Epicotch/Acoustic-Camera/README.md

hi

Firmware is under firmware, actual board is under Microphone board (KiCAD 10), analysis tools is are in pattern analysis, power viewing utility is under power viewer
