Epicotch/Acoustic-Camera/Microphone board/.step

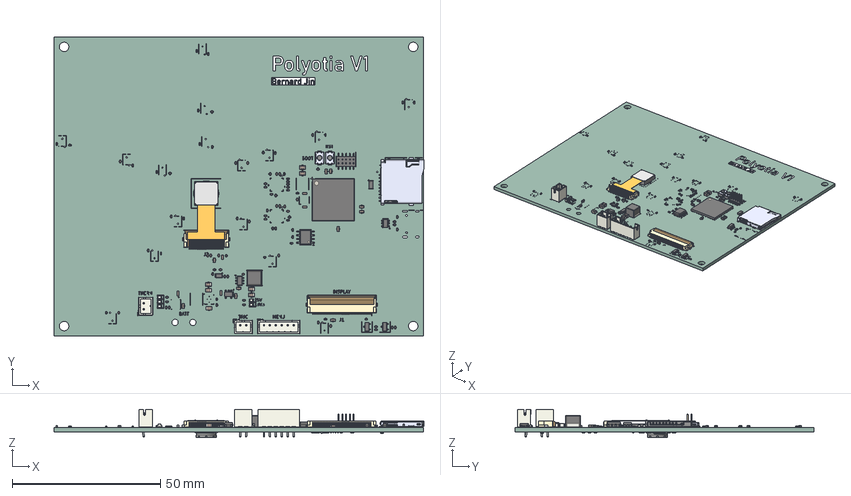
[picture p1: CAD file, 2026-06-13]
Microphone board/.step
124.8 x 101.0 x 9.53 mm
R_0402_1005Metric x 69
lock x 2
pins x 2
C_0603_1608Metric x 15
C_0402_1005Metric x 38
L_Changjiang_FNR5040S
Lense
plate
tail
plate001
conn
film
silk
TS-1088-AR02016 x 2
SOT-23-5
JST_B2B_PH_K x 2
SOIC_8_39x49mm_P127mm
SOT-23 x 2
C_0805_2012Metric x 7
SOT-23-6
LED_0603_1608Metric_Castellated x 5
TSOT-23-6
SOT-583-8
WSON_12_1EP_135x25mm_P04mm_EP04x2mm
JST_B6B_PH_K
TF-01A_TF-01A
TFBGA-265_14x14mm_Layout17x17_P0.8mm
PinHeader_2x05_P127mm_Vertical_SMD
C_0201_0603Metric x 29
Microphone board_silkscreen x 2
Microphone board_PCB
