Epicotch/Acoustic-Camera/Microphone board/models/camera_OV2640_001.step

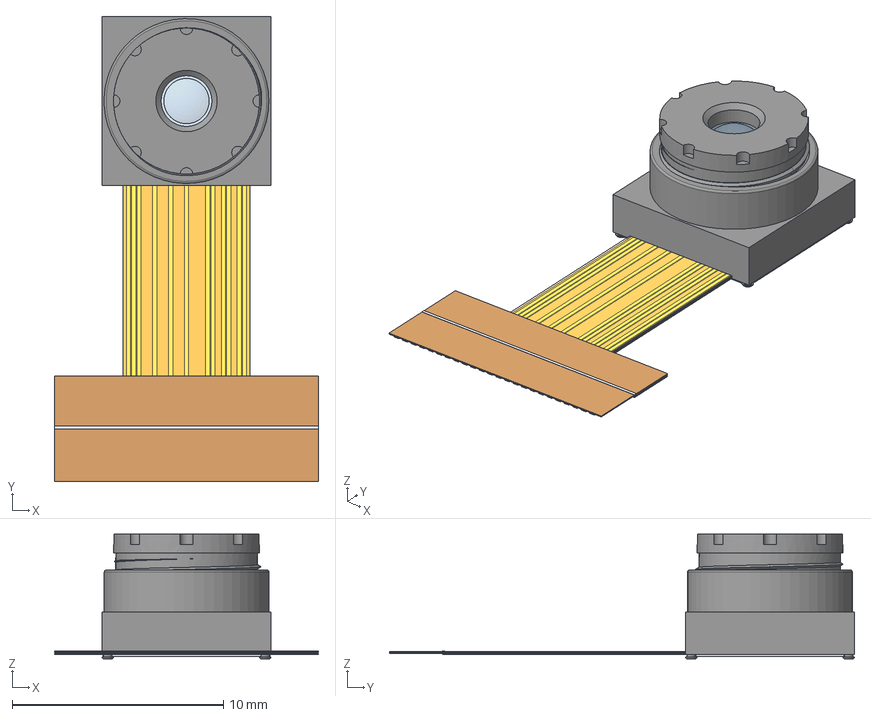
[picture p2: CAD file, 2026-06-10]
Microphone board/models/camera_OV2640_001.step
12.5 x 22.0 x 5.91 mm
Lense
plate
tail
plate001
conn
film
silk
