Epicotch/Acoustic-Camera/Microphone board/models/TF-01A--3DModel-STEP-56544.STEP

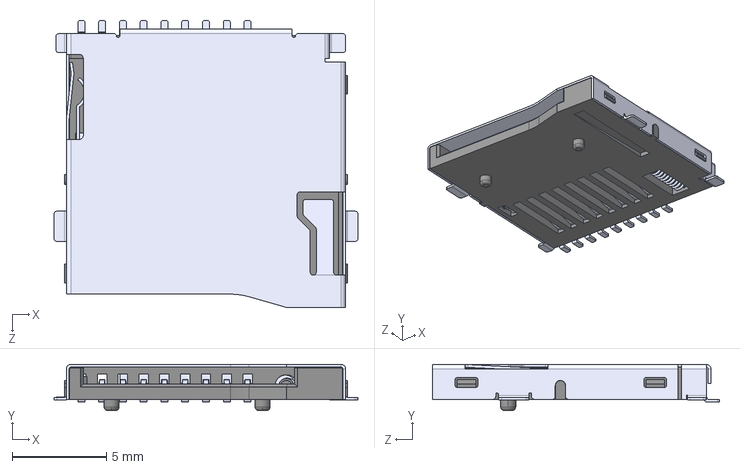
[picture p3: CAD file, 2026-06-08]
Microphone board/models/TF-01A--3DModel-STEP-56544.STEP
16.1 x 2.45 x 15.2 mm
