Epicotch/Acoustic-Camera/Microphone board/Microphone board-B_Cu.pdf

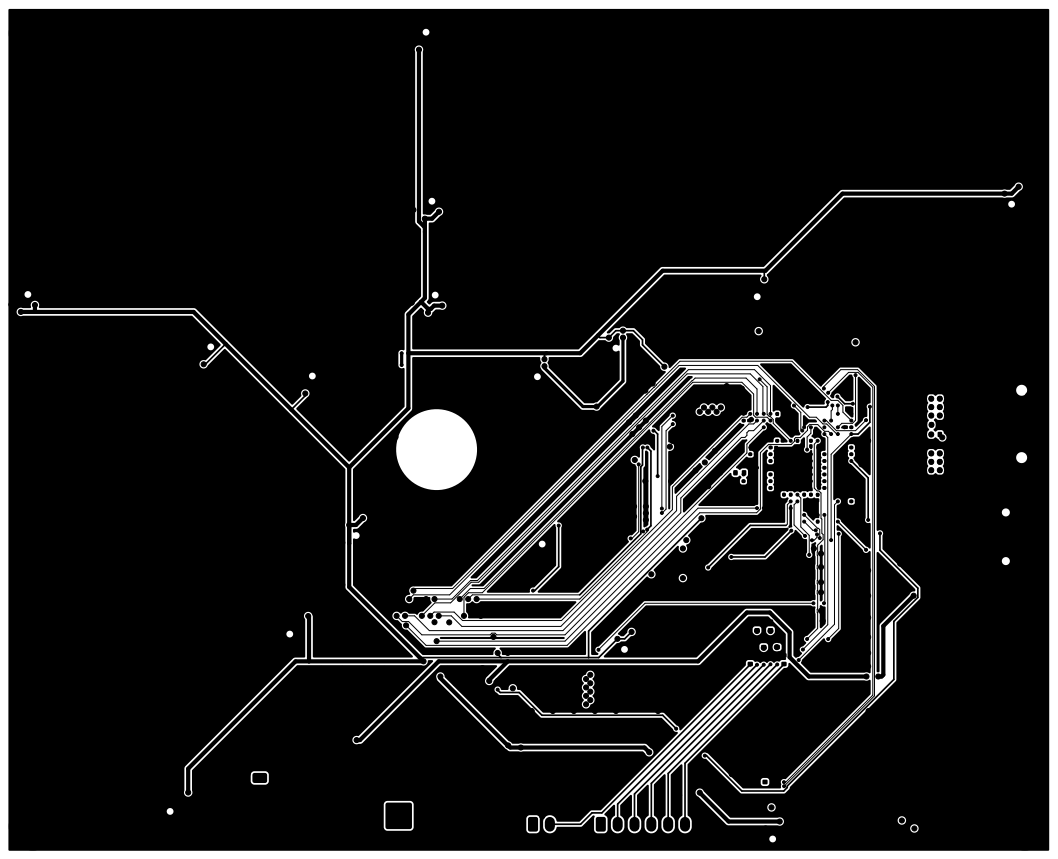
[picture p4: page 1]

Size: A4 | Rev:
KiCad E.D.A. 10.0.3 | Id: 4/11
