Epicotch/Acoustic-Camera/Microphone board/Microphone board-B_Mask.pdf

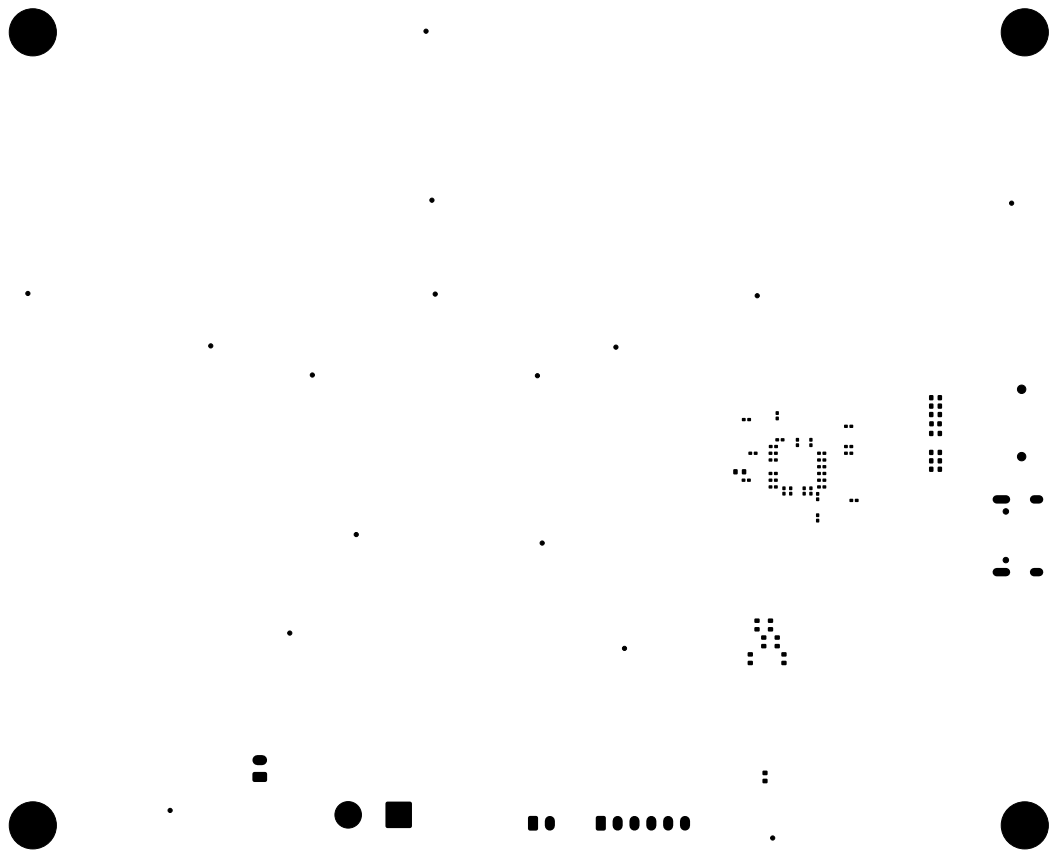
[picture p5: page 1]

Size: A4 | Rev:
KiCad E.D.A. 10.0.3 | Id: 10/11
