Epicotch/Acoustic-Camera/Microphone board/Microphone board-B_Paste.pdf

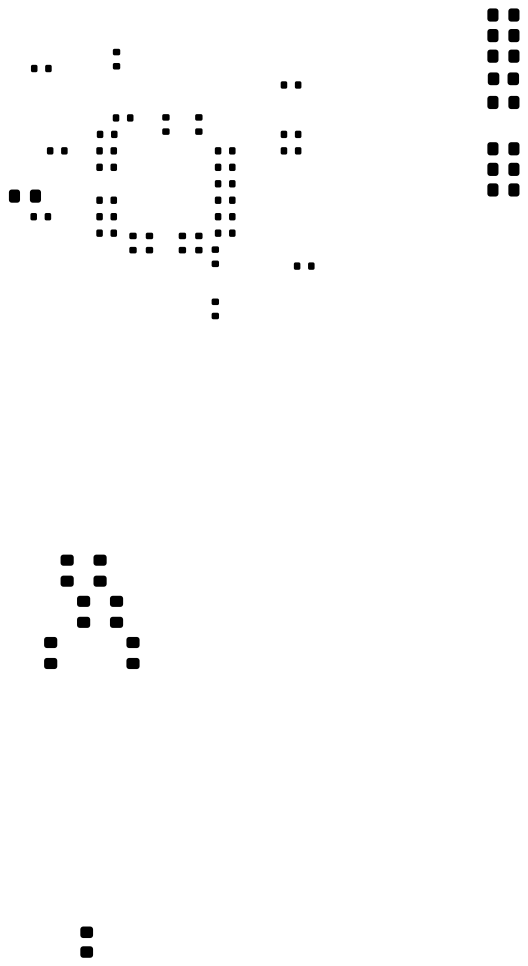
[picture p6: page 1]

Size: A4 | Rev:
KiCad E.D.A. 10.0.3 | Id: 6/11
