Epicotch/Acoustic-Camera/Microphone board/Microphone board-B_Silkscreen.pdf

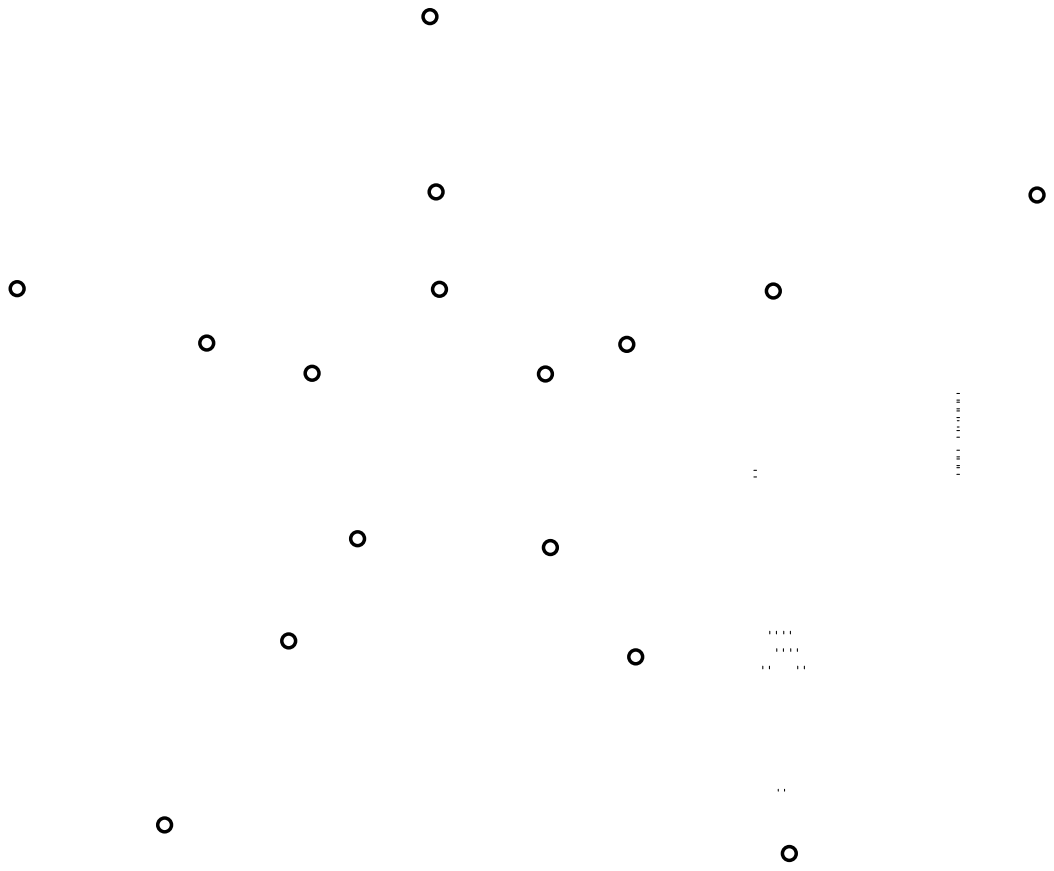
[picture p7: page 1]

Size: A4 | Rev:
KiCad E.D.A. 10.0.3 | Id: 8/11
