Epicotch/Acoustic-Camera/Microphone board/Microphone board-Edge_Cuts.pdf

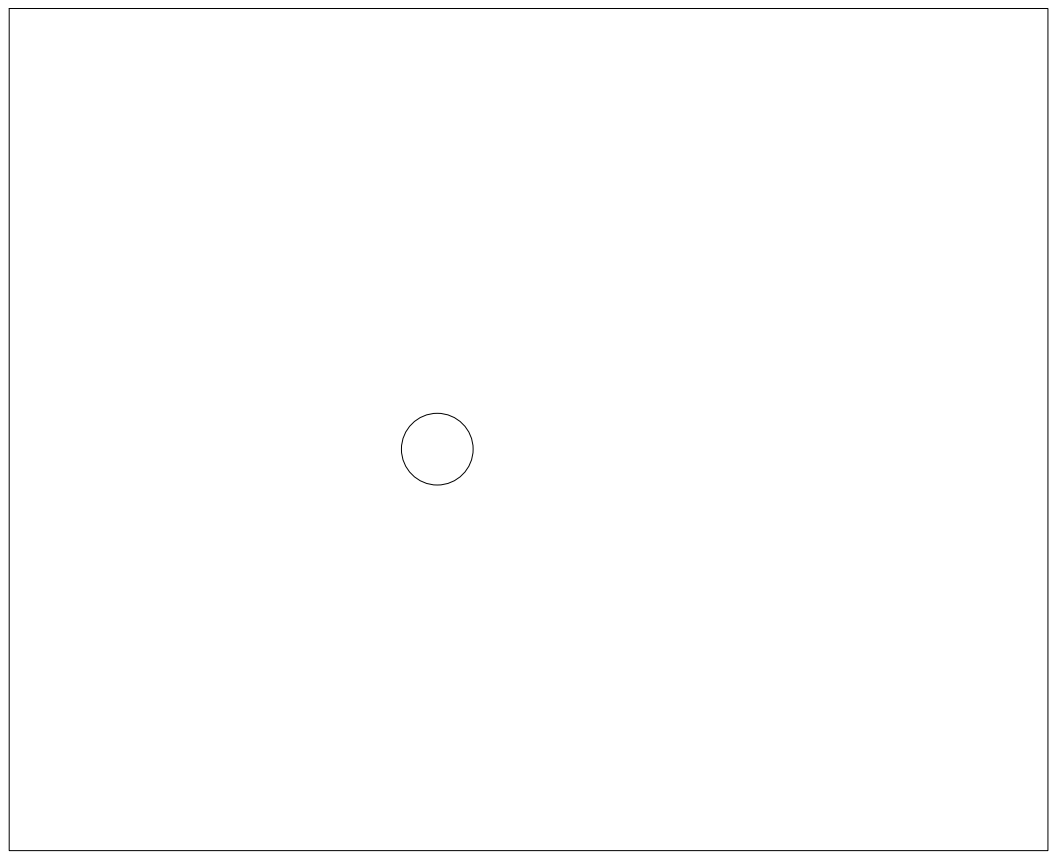
[picture p8: page 1]

Size: A4 | Rev:
KiCad E.D.A. 10.0.3 | Id: 11/11
