Epicotch/Acoustic-Camera/Microphone board/Microphone board-F_Cu.pdf

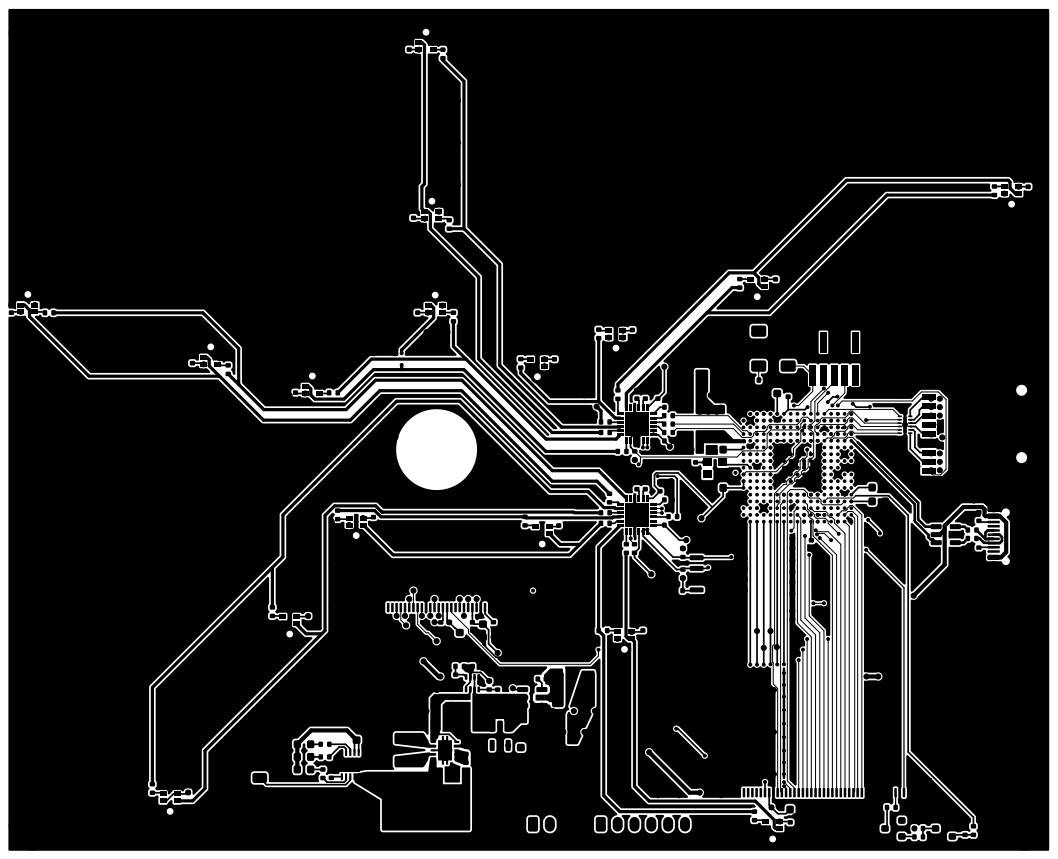
[picture p9: page 1]

Size: A4 | Rev:
KiCad E.D.A. 10.0.3 | Id: 1/11
