Epicotch/Acoustic-Camera/Microphone board/Microphone board-F_Mask.pdf

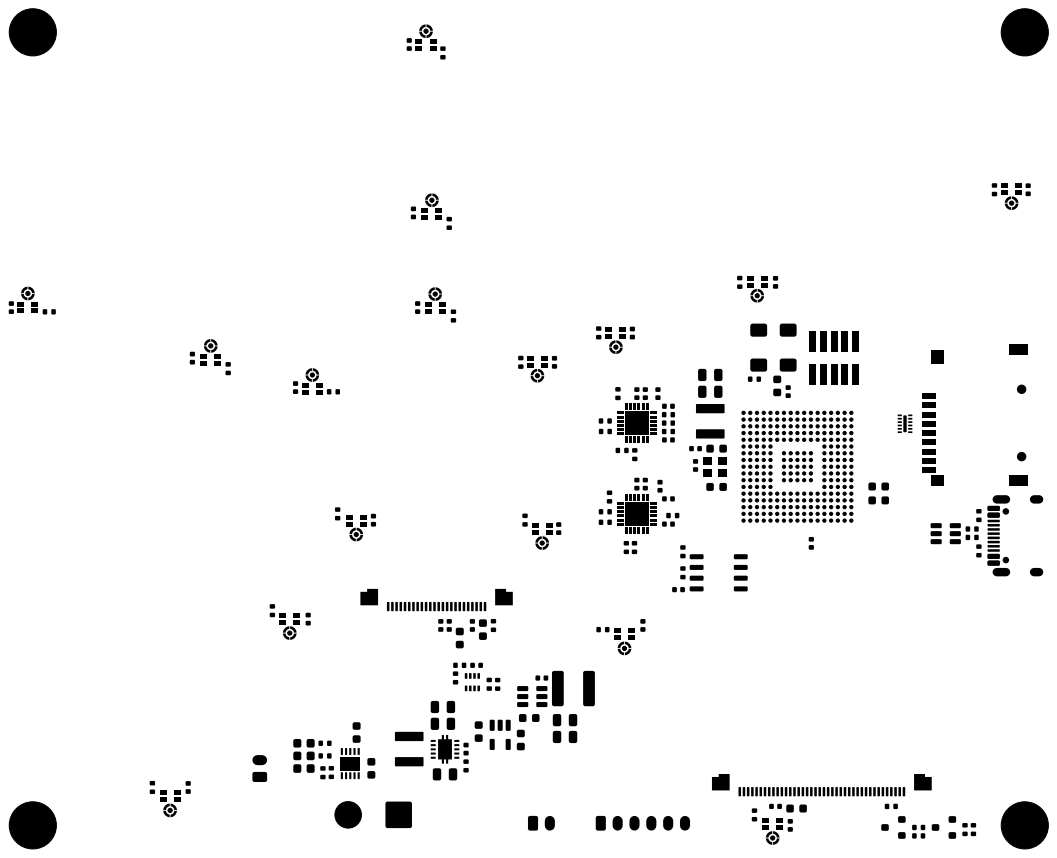
[picture p10: page 1]

Size: A4 | Rev:
KiCad E.D.A. 10.0.3 | Id: 9/11
