Epicotch/Acoustic-Camera/Microphone board/Microphone board-F_Paste.pdf

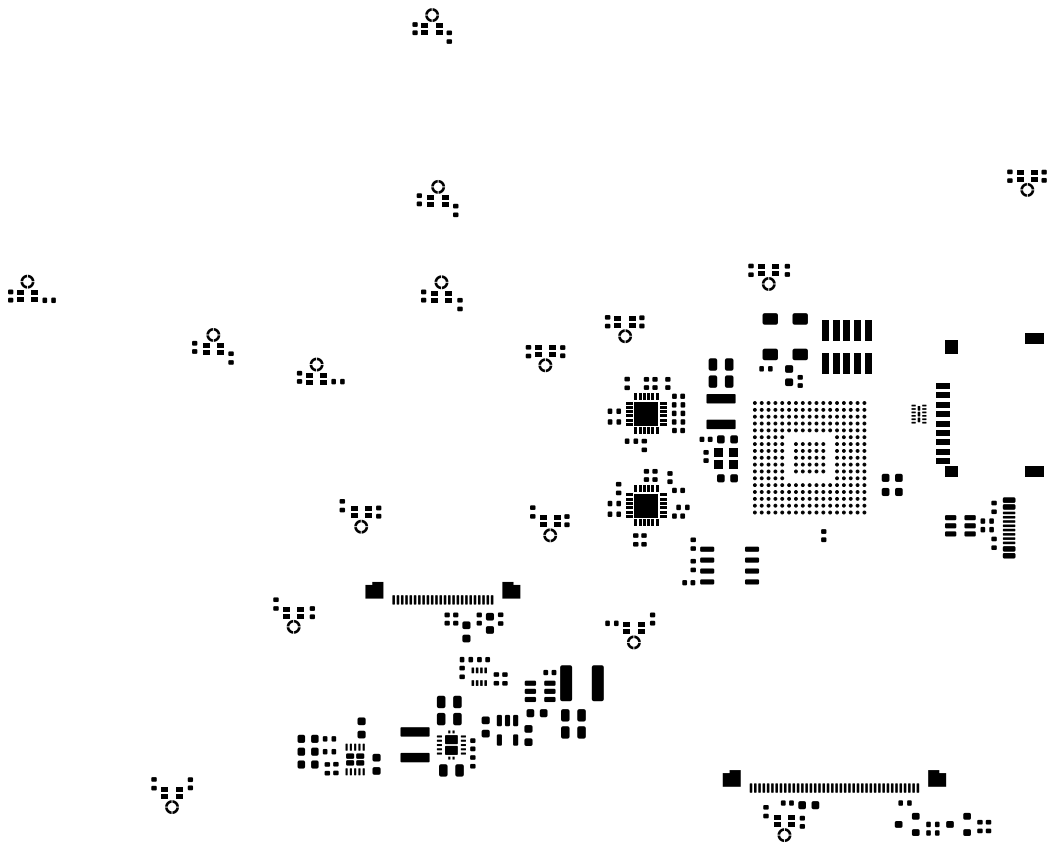
[picture p11: page 1]

Size: A4 | Rev:
KiCad E.D.A. 10.0.3 | Id: 5/11
