Epicotch/Acoustic-Camera/Microphone board/Microphone board-F_Silkscreen.pdf

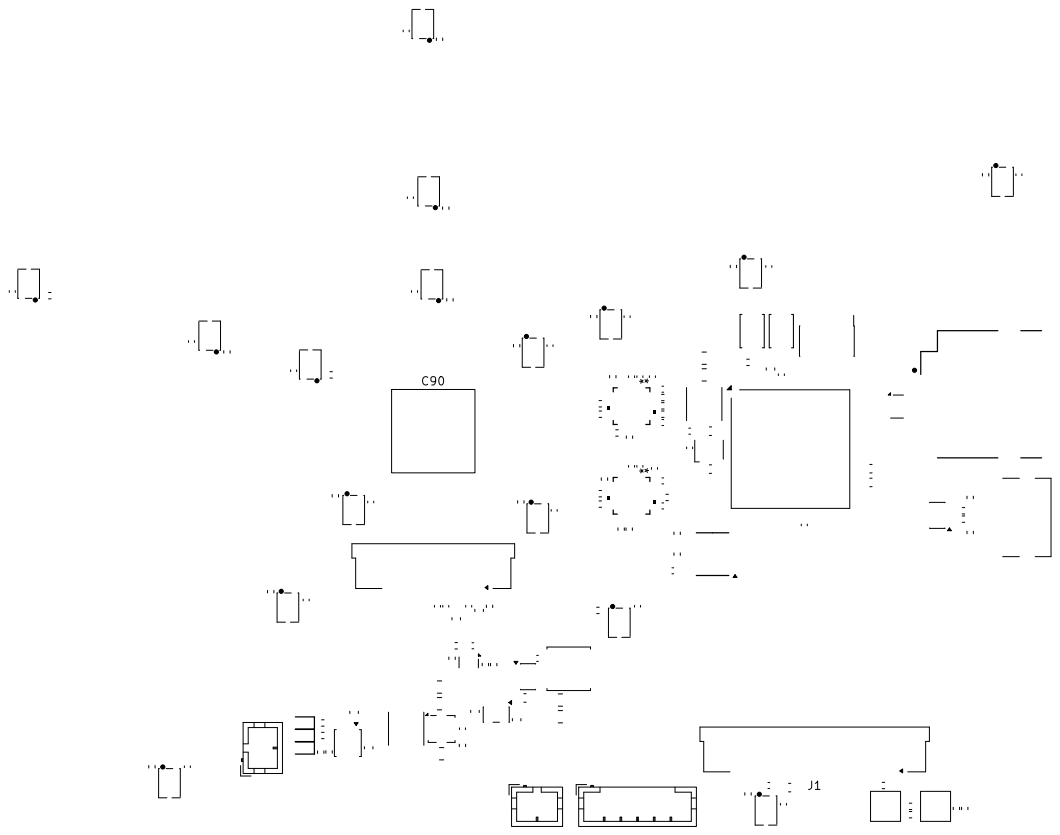
[picture p12: page 1]

Size: A4 | Rev:
KiCad E.D.A. 10.0.3 | Id: 7/11
