Epicotch/Acoustic-Camera/Microphone board/Microphone board-In1_Cu.pdf

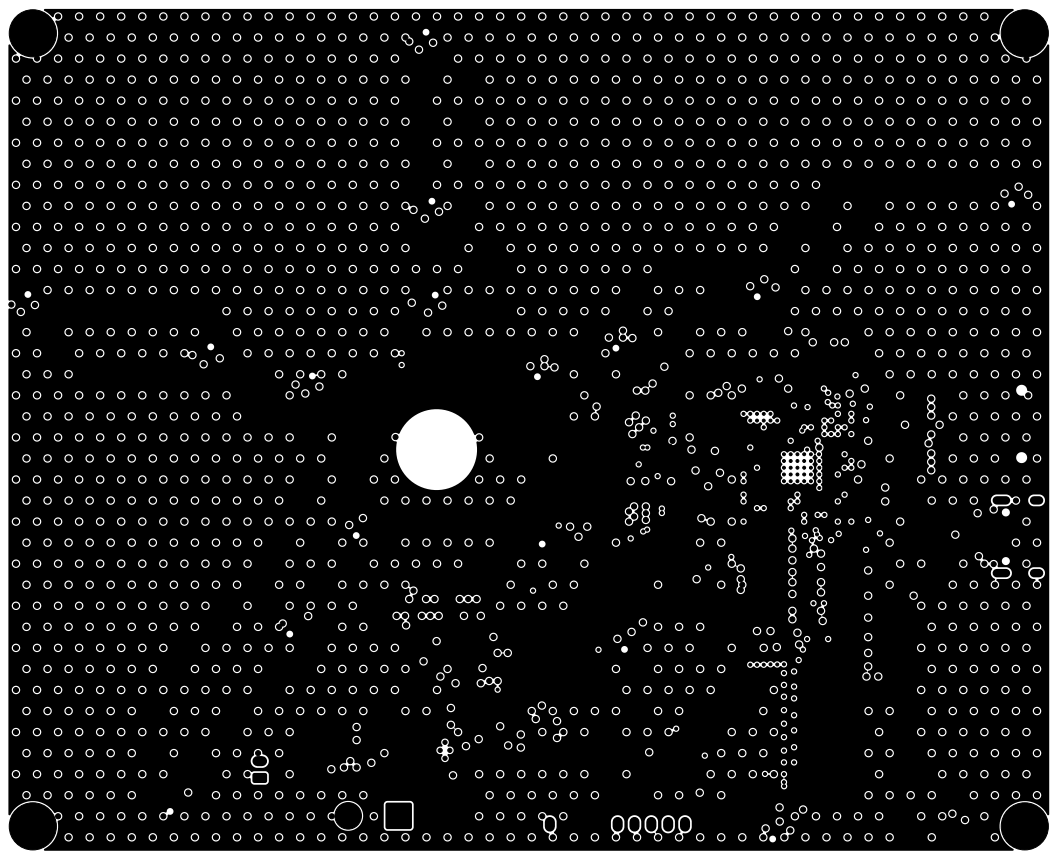
[picture p13: page 1]

Size: A4 | Rev:
KiCad E.D.A. 10.0.3 | Id: 2/11
