Epicotch/Acoustic-Camera/Microphone board/Microphone board-In2_Cu.pdf

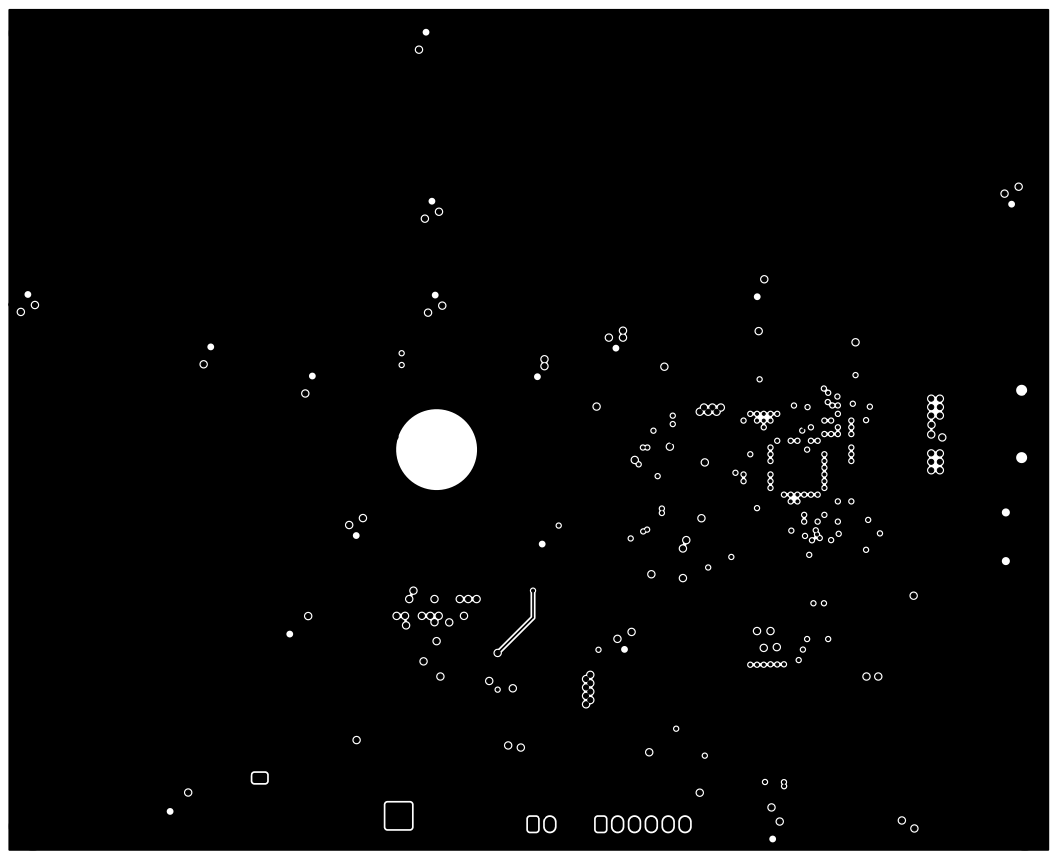
[picture p14: page 1]

Size: A4 | Rev:
KiCad E.D.A. 10.0.3 | Id: 3/11
