Epicotch/Acoustic-Camera/Microphone board/Microphone board.pdf

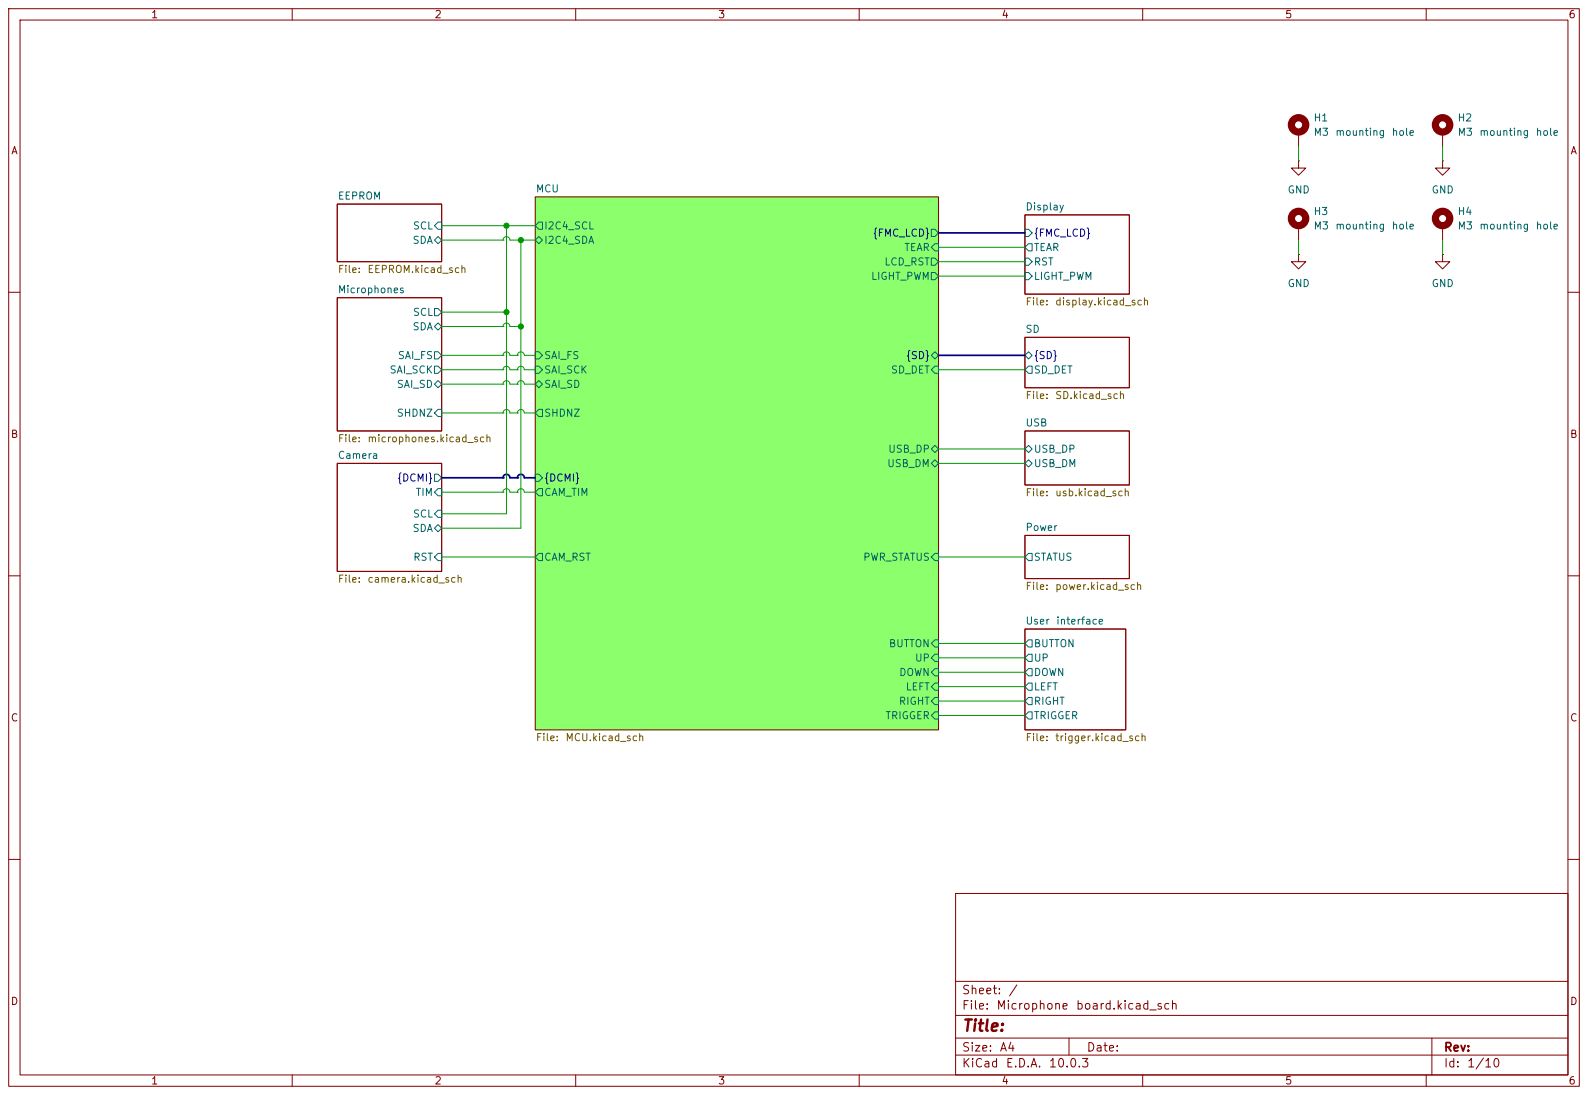
[picture p15: page 1]

Display File: display.kicad_sch BUTTON

SCL SDA SHDNZ Microphones File: microphones.kicad_sch RST SCL SDA

TRIGGER UP User interface

Size: A4 | Rev:
KiCad E.D.A. 10.0.3 | Id: 1/10

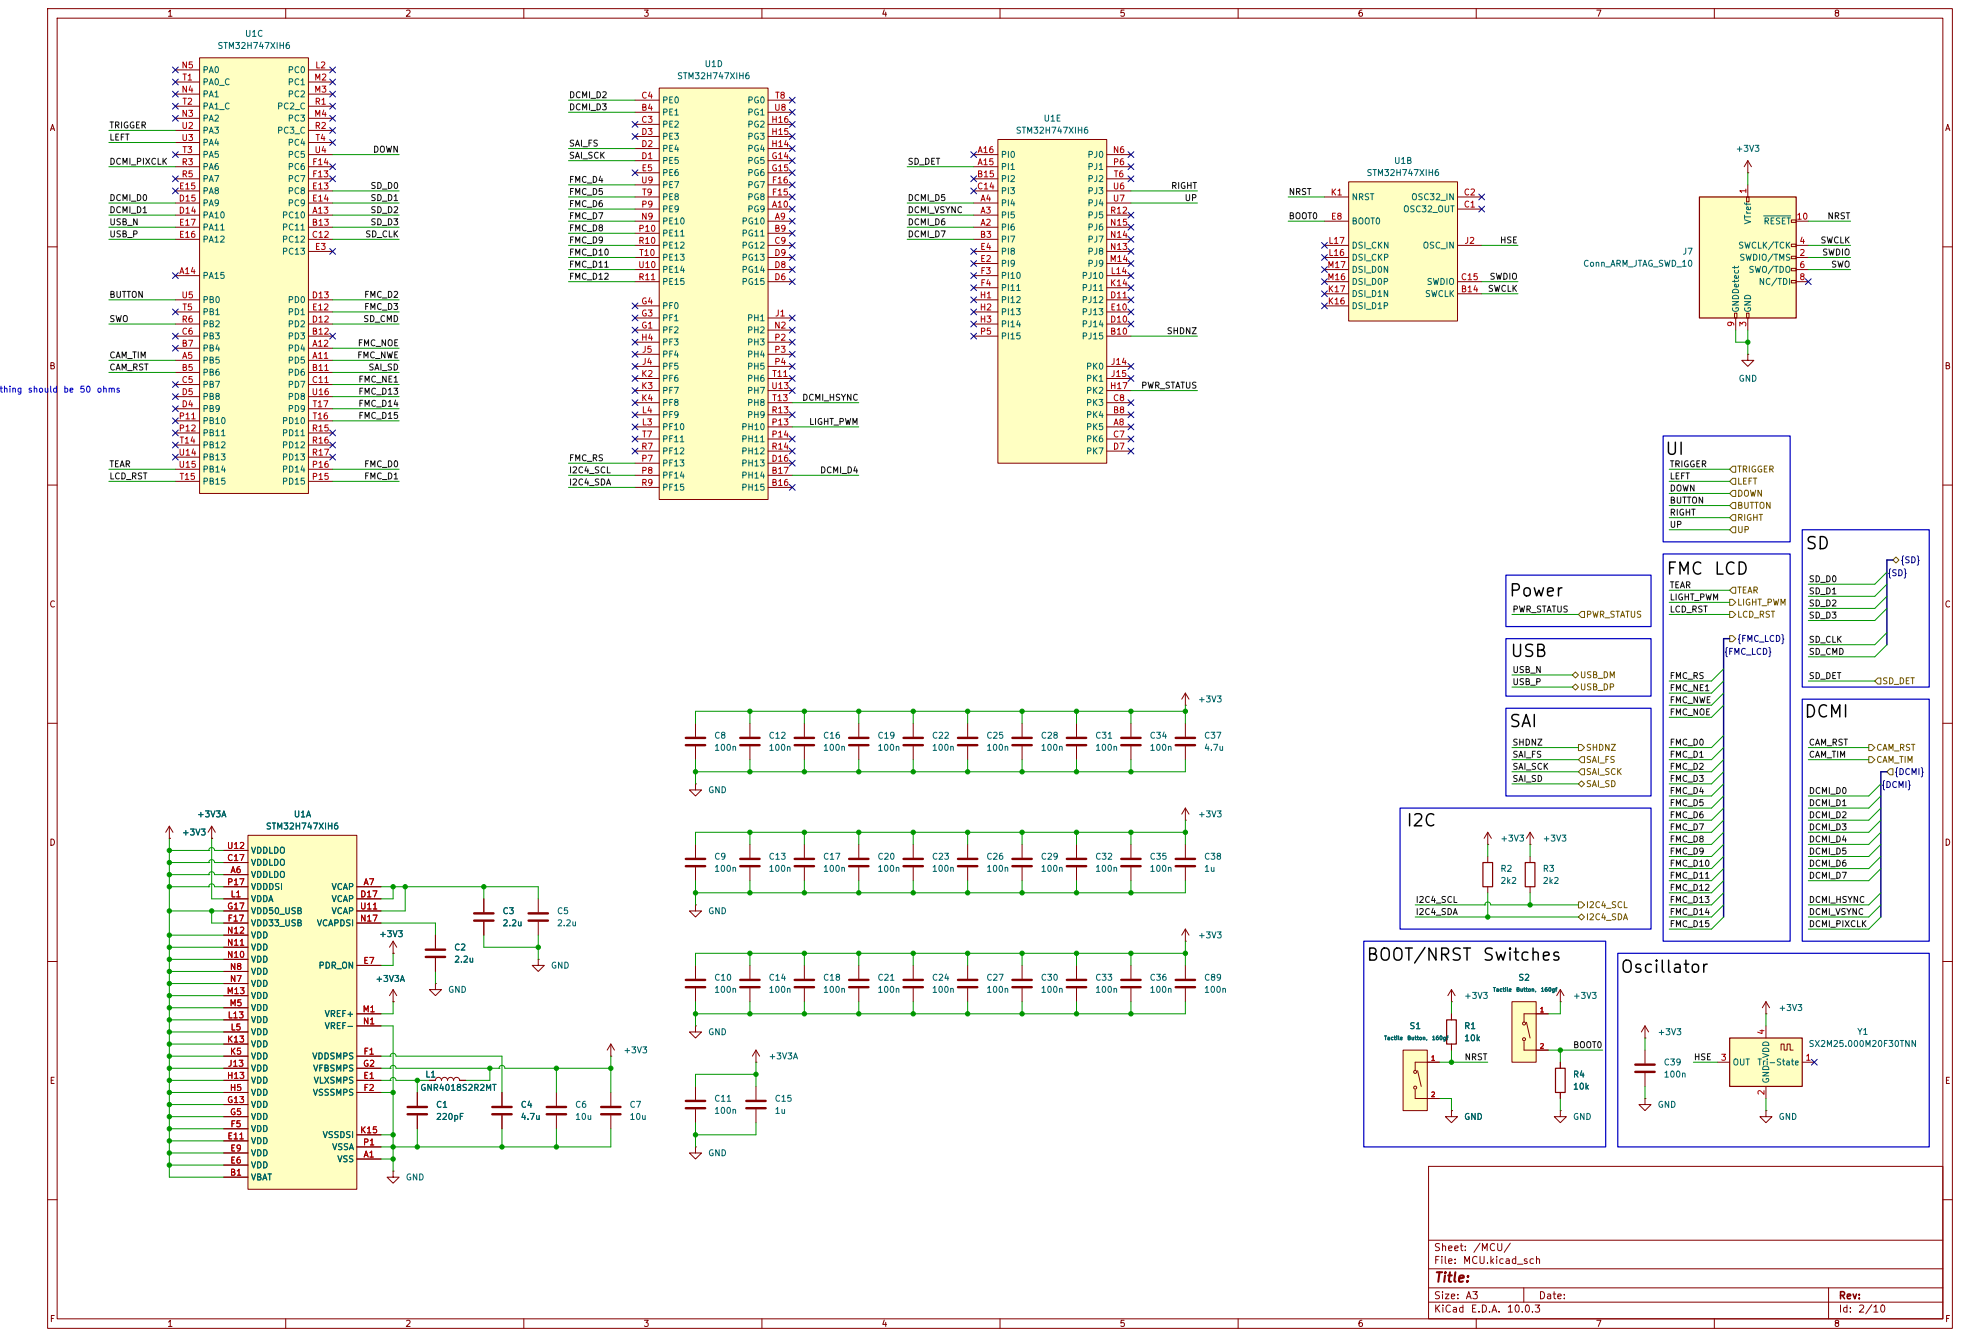
[picture p16: page 2]

FMC LCD TEAR LIGHT_PWM LCD_RST | TEAR {FMC_LCD} LIGHT_PWM

CAM_RST SD_DET DCMI CAM_TIM

BOOT/NRST Switches

Size: A3 | Rev:

F Date:

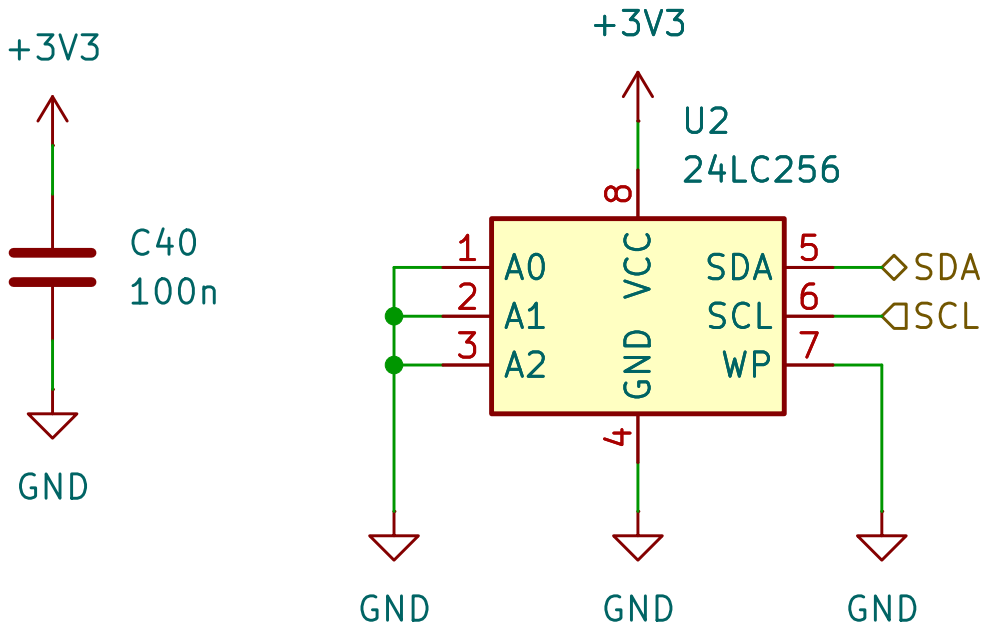
[picture p17: page 3]

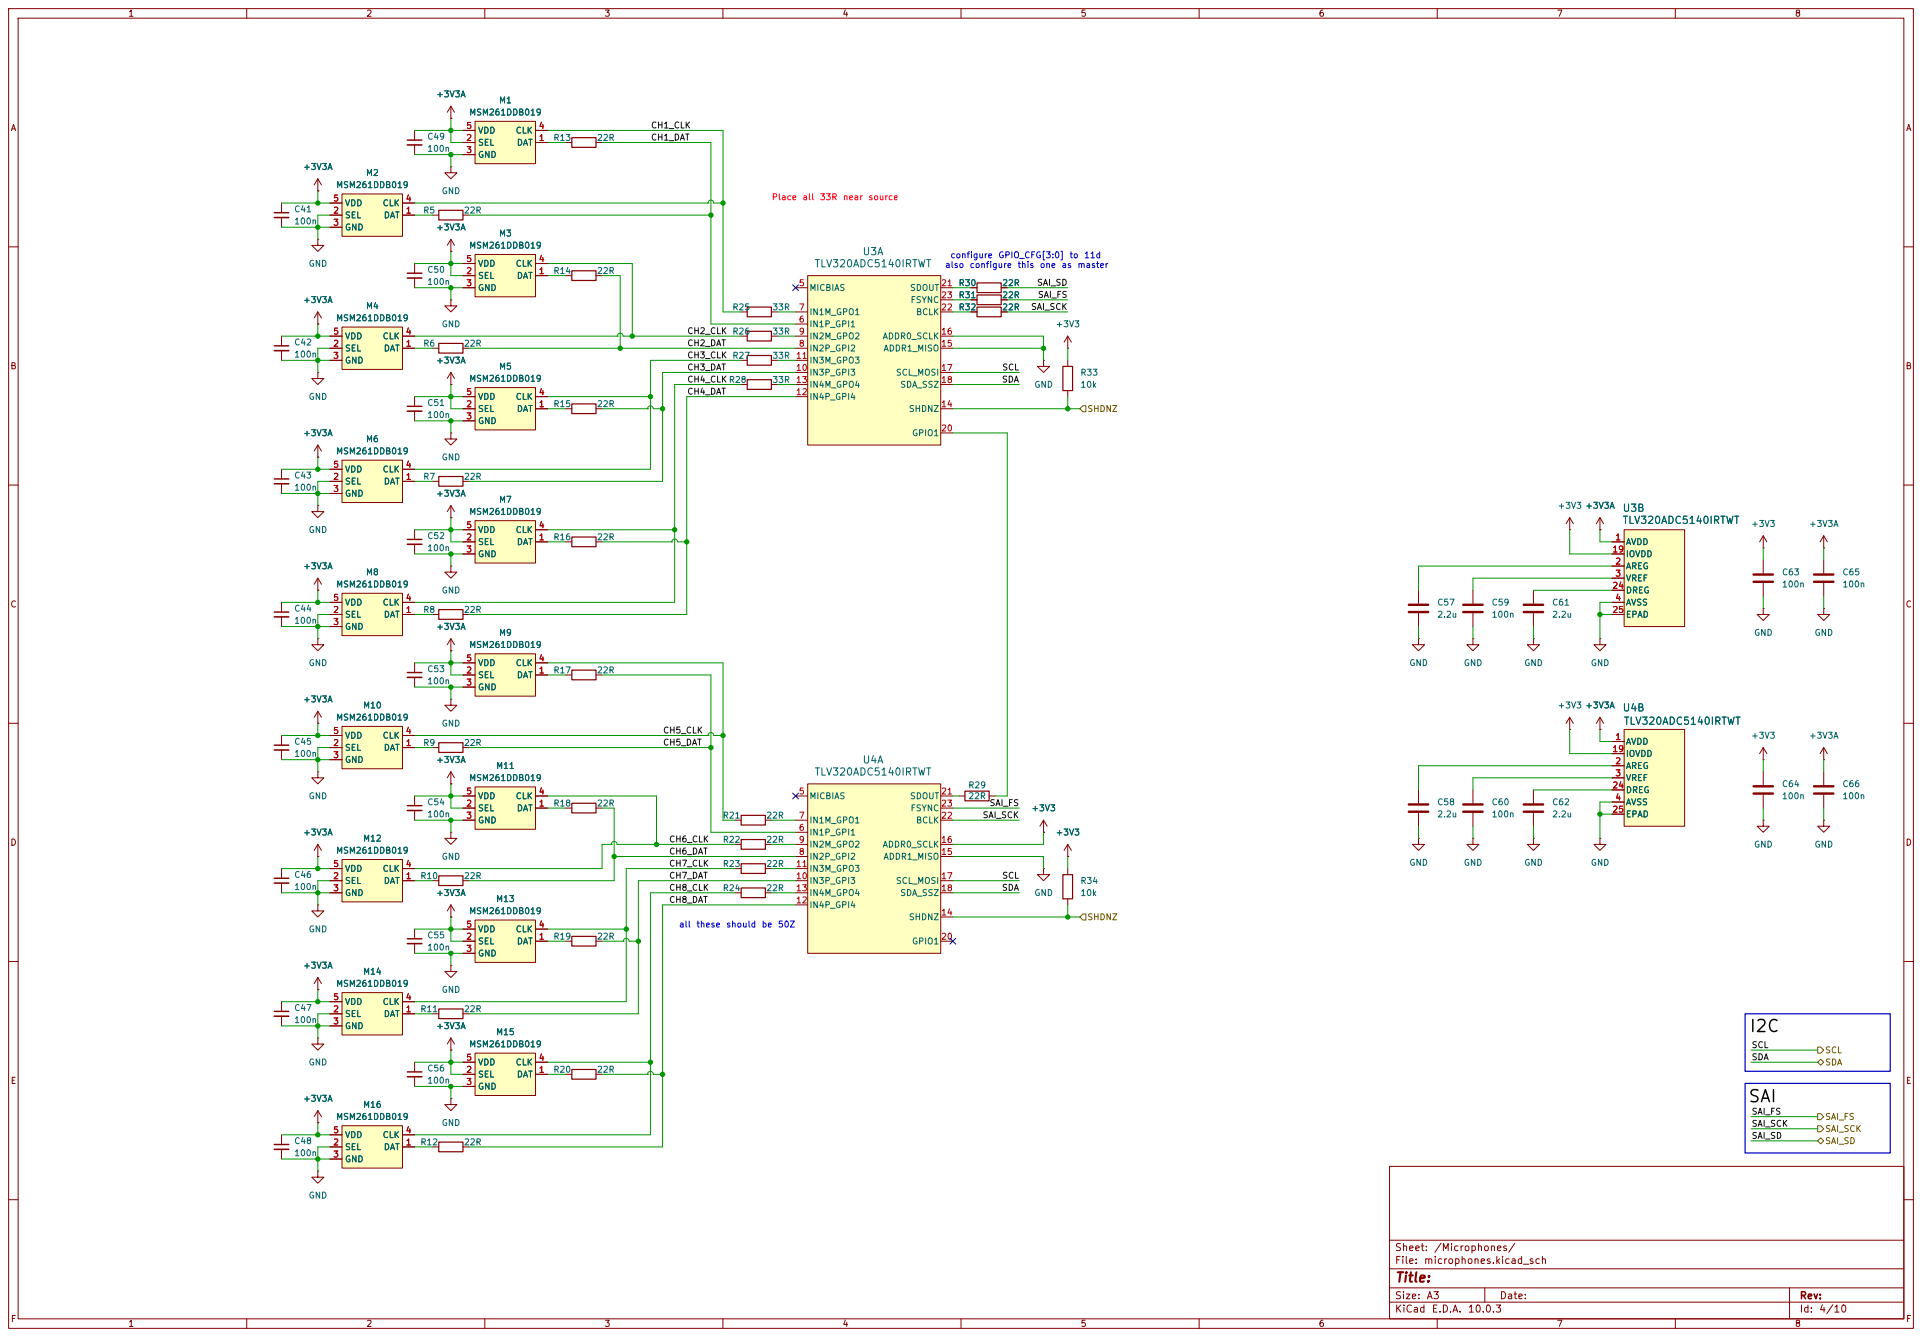
[picture p18: page 4]

Place all 33R near source

configure GPIO_CFG[3:0] to 11d
also configure this one as master

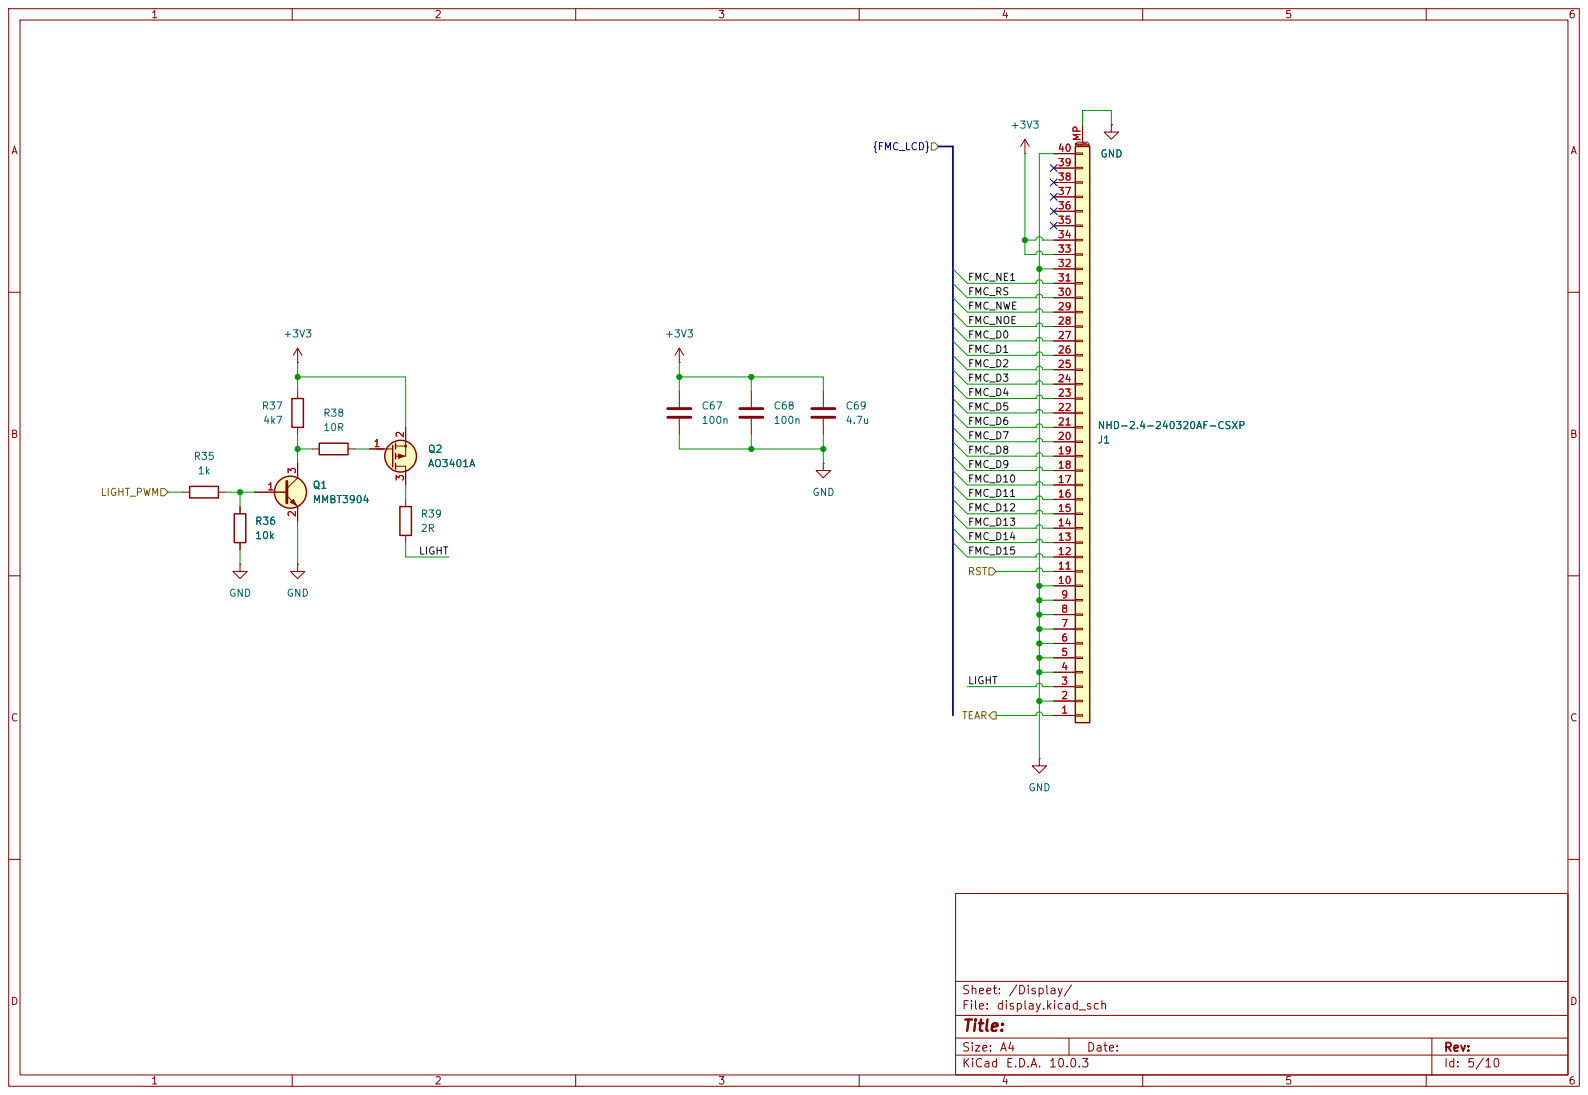
[picture p19: page 5]

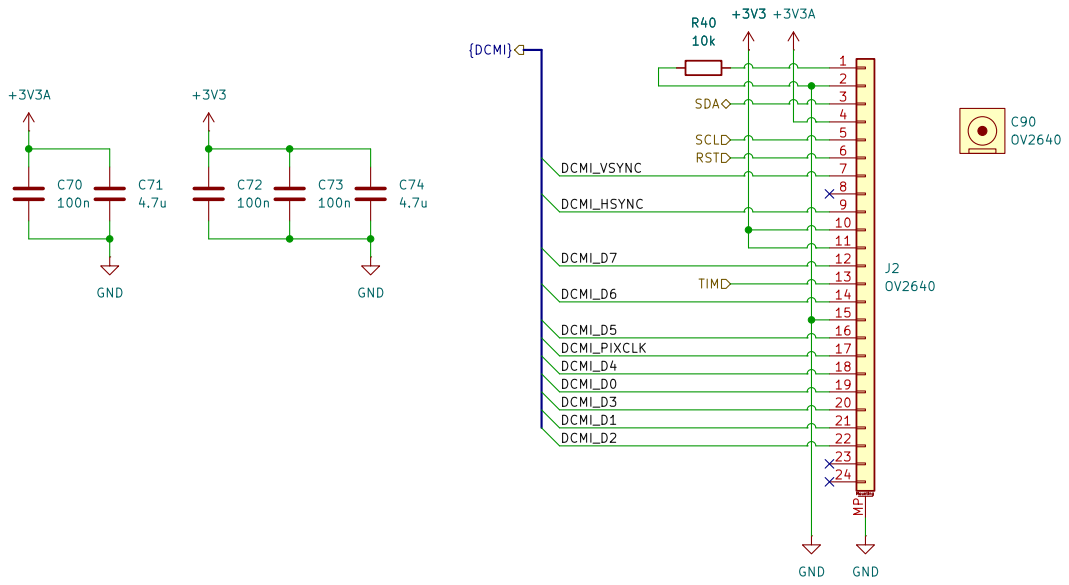
[picture p20: page 6]

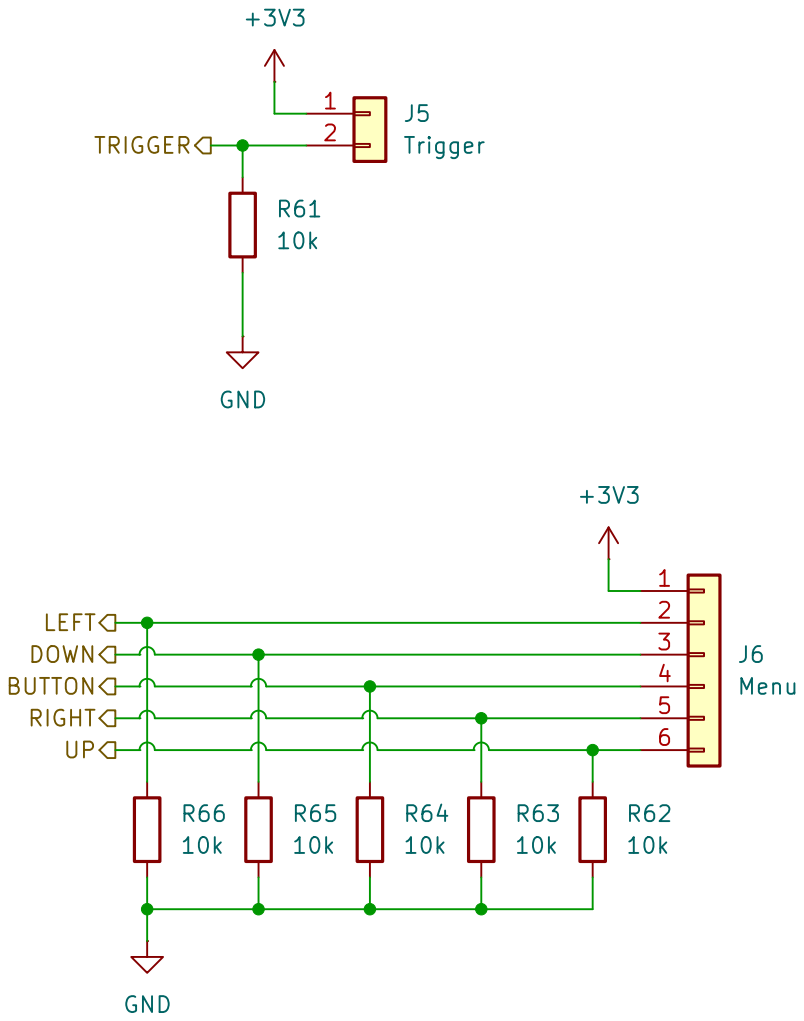
[picture p21: page 7]

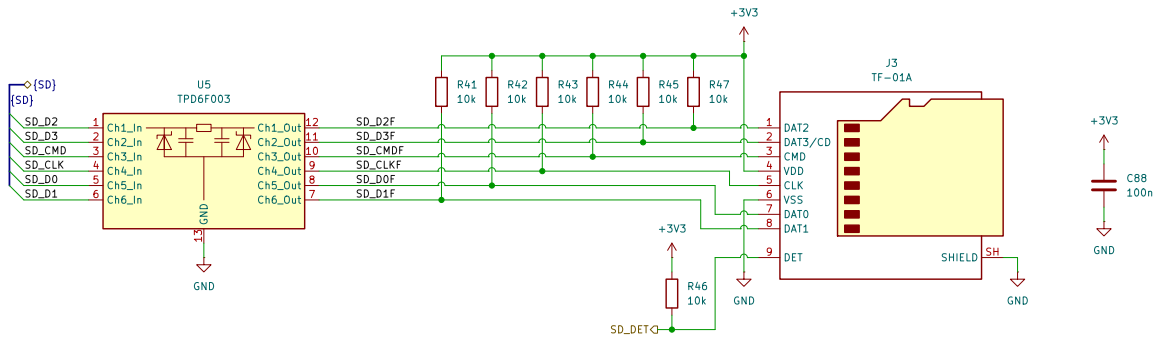
[picture p22: page 8]

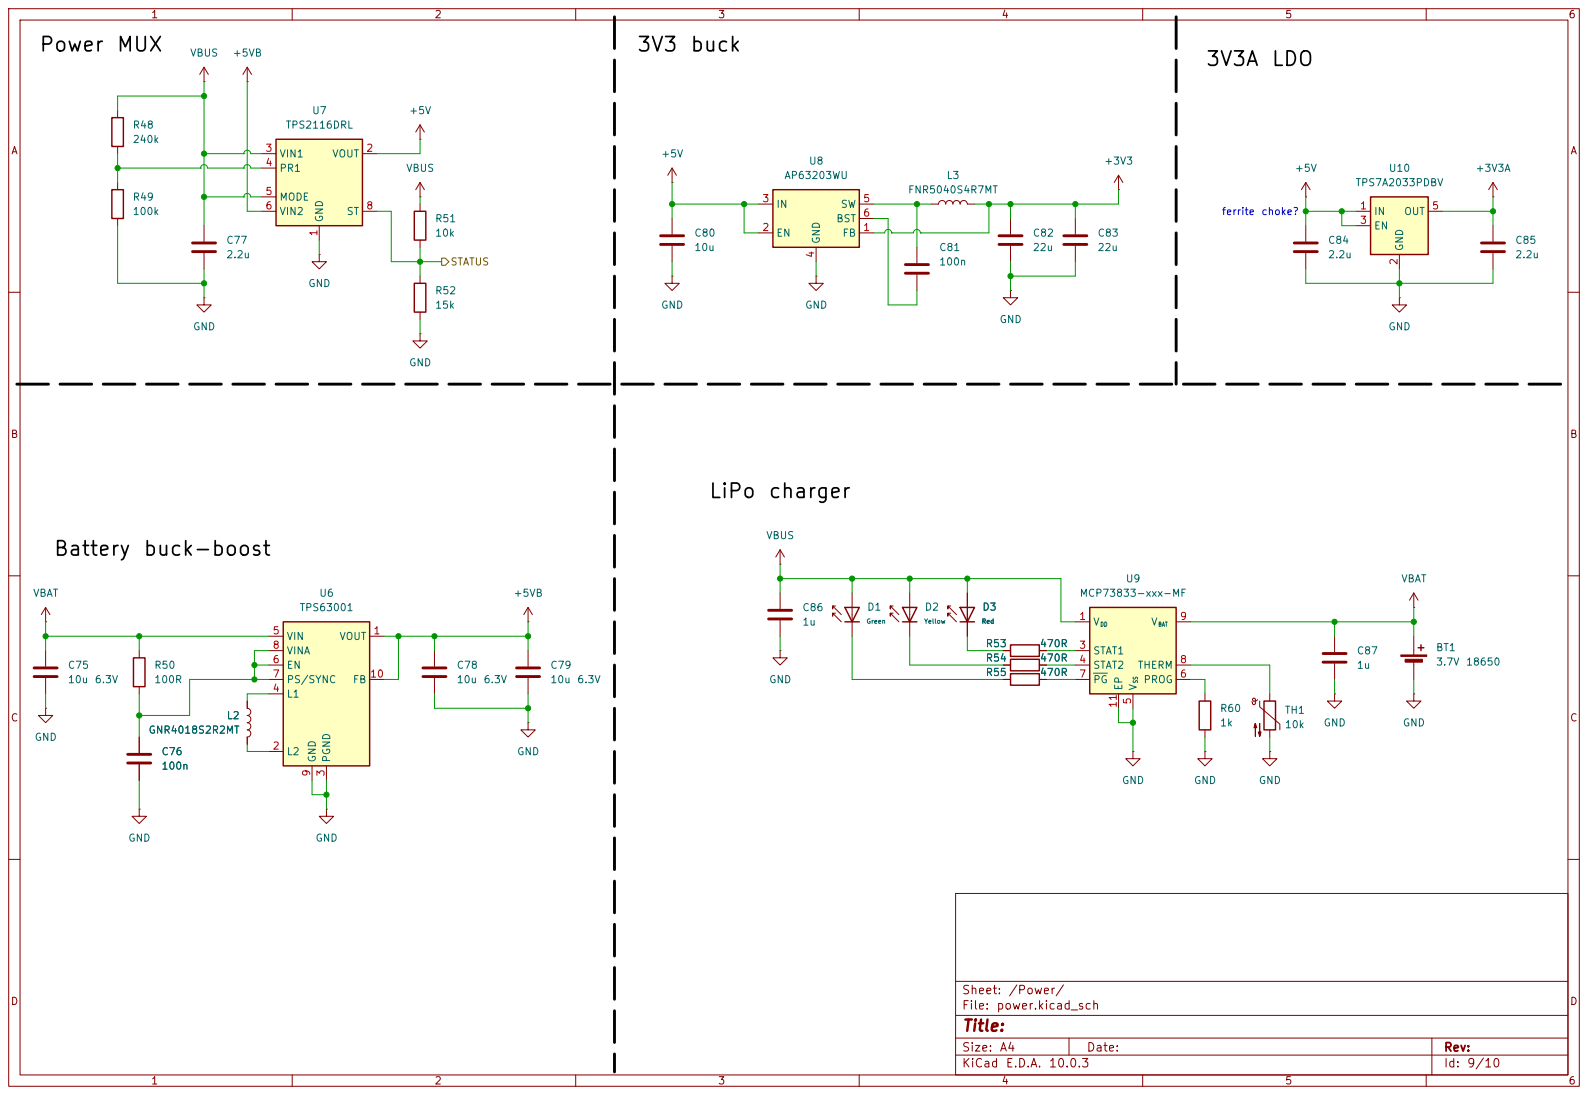
[picture p23: page 9]

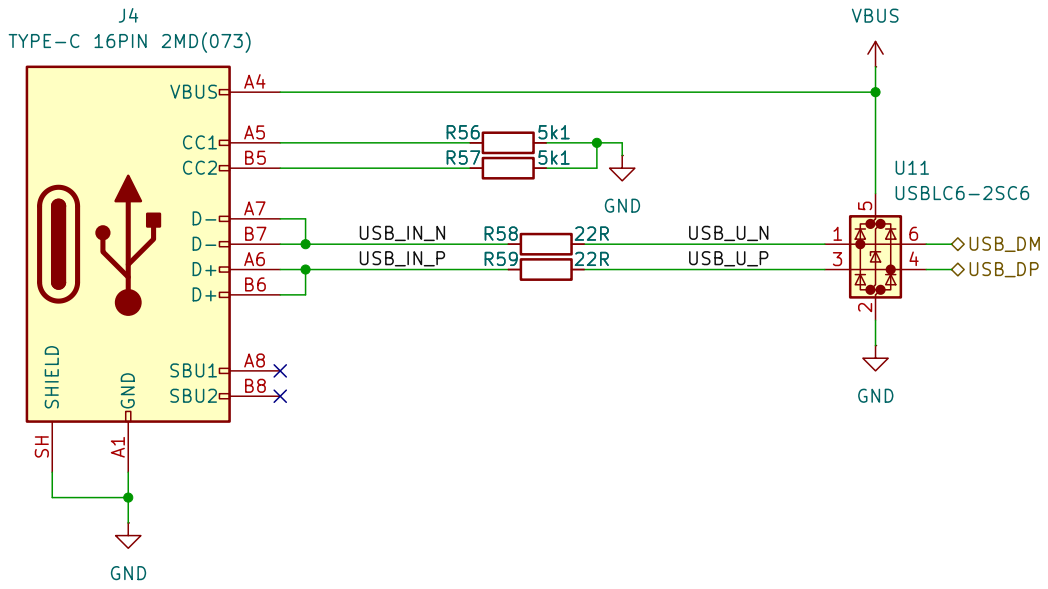
[picture p24: page 10]
