Epicotch/Acoustic-Camera/Microphone board/Microphone board.kicad_pcb

## KiCad design Microphone board/Microphone board.kicad_pcb (2026-07-10)

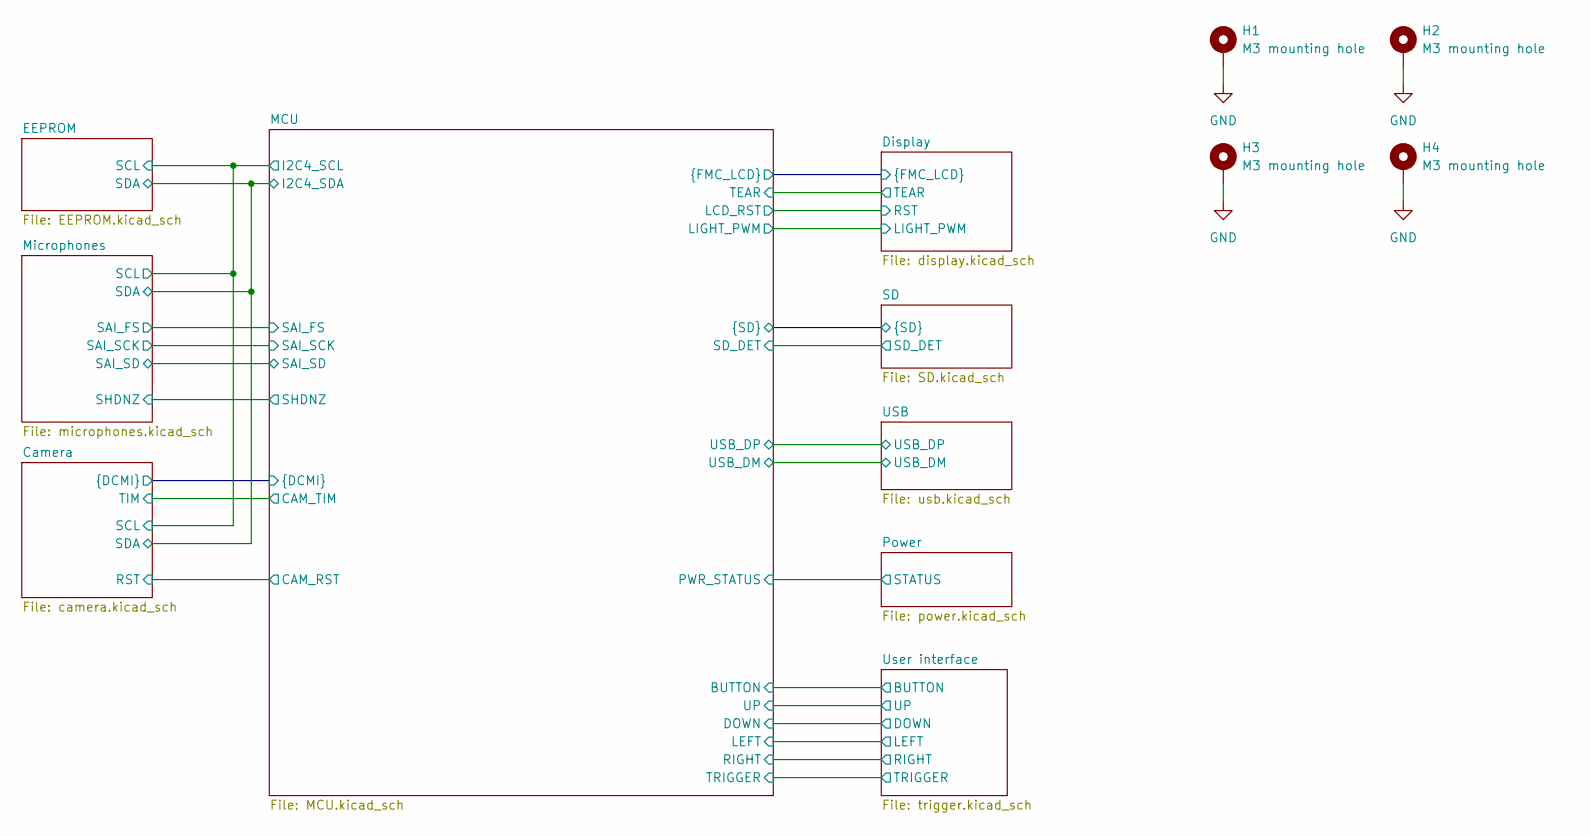
[picture p25: schematic Microphone board.kicad_sch]

Parts:
H1, H2, H3, H4: M3 mounting hole; MountingHole_3.2mm_M3_DIN965_Pad

Connections:
GND: H1.1 (1_1), H2.1 (1_1), H3.1 (1_1), H4.1 (1_1); also elsewhere on the board

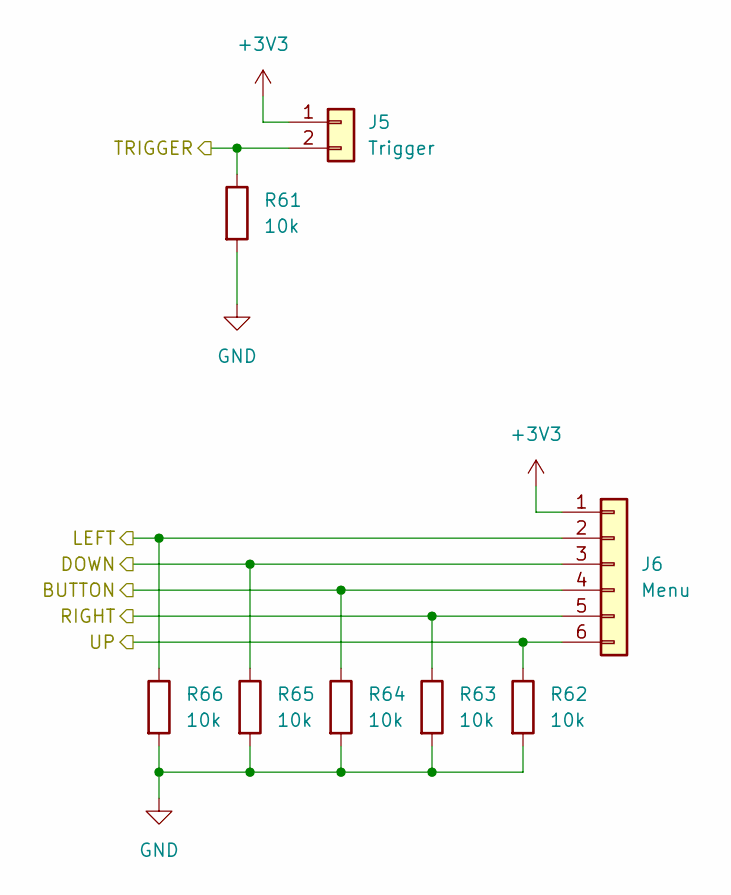
[picture p26: schematic trigger.kicad_sch]

Parts:
J5: Trigger; JST_PH_B2B-PH-K_1x02_P2.00mm_Vertical
J6: Menu; JST_PH_B6B-PH-K_1x06_P2.00mm_Vertical
R61, R62, R63, R64, R65, R66: 10k; R_0402_1005Metric

Connections:
+3V3: J5.1, J6.1; also elsewhere on the board
/MCU/BUTTON: J6.4, R64.1; also elsewhere on the board
/MCU/DOWN: J6.3, R65.1; also elsewhere on the board
/MCU/LEFT: J6.2, R66.1; also elsewhere on the board
/MCU/RIGHT: J6.5, R63.1; also elsewhere on the board
/MCU/TRIGGER: J5.2, R61.1; also elsewhere on the board
/MCU/UP: J6.6, R62.1; also elsewhere on the board
GND: R61.2, R62.2, R63.2, R64.2, R65.2, R66.2; also elsewhere on the board

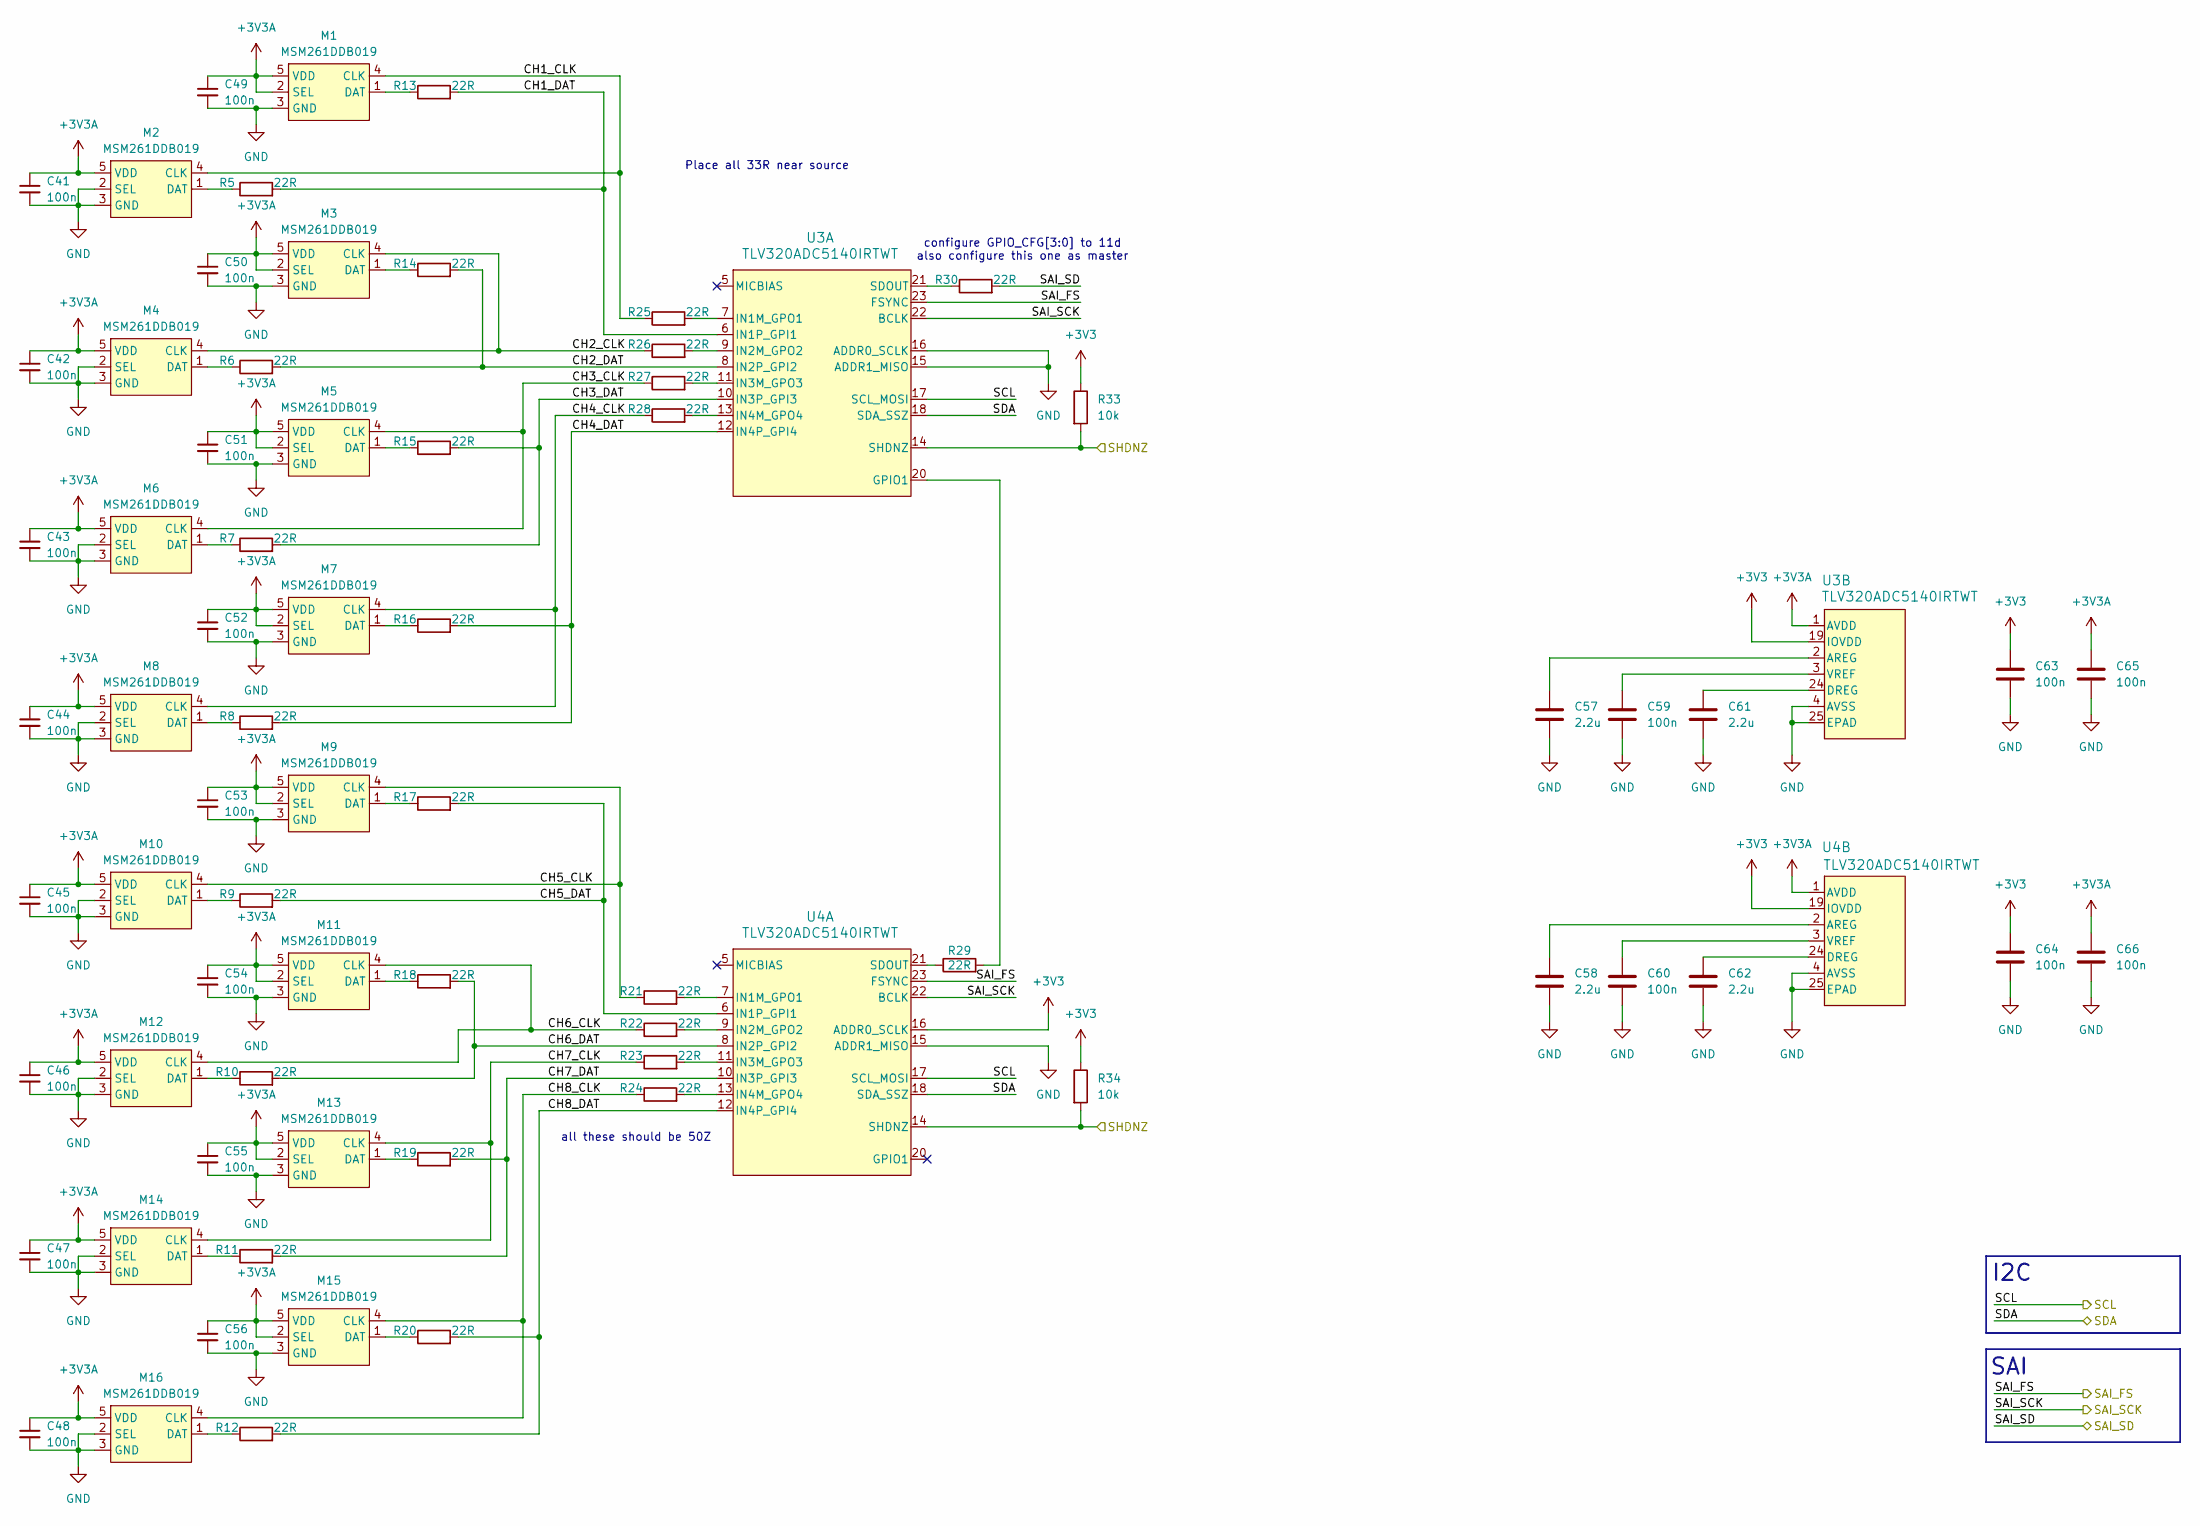
[picture p27: schematic microphones.kicad_sch]

Parts:
C41, C42, C43, C44, C45, C46, C47, C48, C49, C50, C51, C52, C53, C54, C55, C56, C59, C60, C63, C64, C65, C66: 100n; C_0402_1005Metric
C57, C58, C61, C62: 2.2u; C_0402_1005Metric
M1, M2, M3, M4, M5, M6, M7, M8, M9, M10, M11, M12, M13, M14, M15, M16: MSM261DDB019
R5, R6, R7, R8, R9, R10, R11, R12, R13, R14, R15, R16, R17, R18, R19, R20, R21, R22, R23, R24, R25, R26, R27, R28, R29, R30: 22R; R_0402_1005Metric
R33, R34: 10k; R_0402_1005Metric
U3, U4: TLV320ADC5140IRTWT; RTW24_4P15X4P15_TEX

Connections:
+3V3: C63.1, C64.1, R33.1, R34.1, U3.19 (IOVDD), U4.16 (ADDR0_SCLK), U4.19 (IOVDD); also elsewhere on the board
+3V3A: C41.1, C42.1, C43.1, C44.1, C45.1, C46.1, C47.1, C48.1, C49.1, C50.1, C51.1, C52.1, C53.1, C54.1, C55.1, C56.1, C65.1, C66.1, M1.2 (SEL), M1.5 (VDD), M2.5 (VDD), M3.2 (SEL), M3.5 (VDD), M4.5 (VDD), M5.2 (SEL), M5.5 (VDD), M6.5 (VDD), M7.2 (SEL), M7.5 (VDD), M8.5 (VDD), M9.2 (SEL), M9.5 (VDD), M10.5 (VDD), M11.2 (SEL), M11.5 (VDD), M12.5 (VDD), M13.2 (SEL), M13.5 (VDD), M14.5 (VDD), M15.2 (SEL), M15.5 (VDD), M16.5 (VDD), U3.1 (AVDD), U4.1 (AVDD); also elsewhere on the board
/MCU/I2C4_SCL: U3.17 (SCL_MOSI), U4.17 (SCL_MOSI); also elsewhere on the board
/MCU/I2C4_SDA: U3.18 (SDA_SSZ), U4.18 (SDA_SSZ); also elsewhere on the board
/MCU/SAI_FS: U3.23 (FSYNC), U4.23 (FSYNC); also elsewhere on the board
/MCU/SAI_SCK: U3.22 (BCLK), U4.22 (BCLK); also elsewhere on the board
/MCU/SAI_SD: R30.2; also elsewhere on the board
/MCU/SHDNZ: R33.2, R34.2, U3.14 (SHDNZ), U4.14 (SHDNZ); also elsewhere on the board
/Microphones/CH1_CLK: M1.4 (CLK), M2.4 (CLK), R25.1
/Microphones/CH1_DAT: R5.2, R13.2, U3.6 (IN1P_GPI1)
/Microphones/CH2_CLK: M3.4 (CLK), M4.4 (CLK), R26.1
/Microphones/CH2_DAT: R6.2, R14.2, U3.8 (IN2P_GPI2)
/Microphones/CH3_CLK: M5.4 (CLK), M6.4 (CLK), R27.1
/Microphones/CH3_DAT: R7.2, R15.2, U3.10 (IN3P_GPI3)
/Microphones/CH4_CLK: M7.4 (CLK), M8.4 (CLK), R28.1
/Microphones/CH4_DAT: R8.2, R16.2, U3.12 (IN4P_GPI4)
/Microphones/CH5_CLK: M9.4 (CLK), M10.4 (CLK), R21.1
/Microphones/CH5_DAT: R9.2, R17.2, U4.6 (IN1P_GPI1)
/Microphones/CH6_CLK: M11.4 (CLK), M12.4 (CLK), R22.1
/Microphones/CH6_DAT: R10.2, R18.2, U4.8 (IN2P_GPI2)
/Microphones/CH7_CLK: M13.4 (CLK), M14.4 (CLK), R23.1
/Microphones/CH7_DAT: R11.2, R19.2, U4.10 (IN3P_GPI3)
/Microphones/CH8_CLK: M15.4 (CLK), M16.4 (CLK), R24.1
/Microphones/CH8_DAT: R12.2, R20.2, U4.12 (IN4P_GPI4)
GND: C41.2, C42.2, C43.2, C44.2, C45.2, C46.2, C47.2, C48.2, C49.2, C50.2, C51.2, C52.2, C53.2, C54.2, C55.2, C56.2, C57.2, C58.2, C59.2, C60.2, C61.2, C62.2, C63.2, C64.2, C65.2, C66.2, M1.3 (GND), M2.2 (SEL), M2.3 (GND), M3.3 (GND), M4.2 (SEL), M4.3 (GND), M5.3 (GND), M6.2 (SEL), M6.3 (GND), M7.3 (GND), M8.2 (SEL), M8.3 (GND), M9.3 (GND), M10.2 (SEL), M10.3 (GND), M11.3 (GND), M12.2 (SEL), M12.3 (GND), M13.3 (GND), M14.2 (SEL), M14.3 (GND), M15.3 (GND), M16.2 (SEL), M16.3 (GND), U3.4 (AVSS), U3.15 (ADDR1_MISO), U3.16 (ADDR0_SCLK), U3.25 (EPAD), U4.4 (AVSS), U4.15 (ADDR1_MISO), U4.25 (EPAD); also elsewhere on the board
unnamed: M1.1 (DAT), R13.1
unnamed: M2.1 (DAT), R5.1
unnamed: M3.1 (DAT), R14.1
unnamed: M4.1 (DAT), R6.1
unnamed: M5.1 (DAT), R15.1
unnamed: M6.1 (DAT), R7.1
unnamed: M7.1 (DAT), R16.1
unnamed: M8.1 (DAT), R8.1
unnamed: M9.1 (DAT), R17.1
unnamed: M10.1 (DAT), R9.1
unnamed: M11.1 (DAT), R18.1
unnamed: M12.1 (DAT), R10.1
unnamed: M13.1 (DAT), R19.1
unnamed: M14.1 (DAT), R11.1
unnamed: M15.1 (DAT), R20.1
unnamed: M16.1 (DAT), R12.1
unnamed: R29.2, U3.20 (GPIO1)
unnamed: R25.2, U3.7 (IN1M_GPO1)
unnamed: R26.2, U3.9 (IN2M_GPO2)
unnamed: R27.2, U3.11 (IN3M_GPO3)
unnamed: R28.2, U3.13 (IN4M_GPO4)
unnamed: R30.1, U3.21 (SDOUT)
unnamed: C57.1, U3.2 (AREG)
unnamed: C61.1, U3.24 (DREG)
unnamed: C59.1, U3.3 (VREF)
unnamed: R21.2, U4.7 (IN1M_GPO1)
unnamed: R22.2, U4.9 (IN2M_GPO2)
unnamed: R23.2, U4.11 (IN3M_GPO3)
unnamed: R24.2, U4.13 (IN4M_GPO4)
unnamed: R29.1, U4.21 (SDOUT)
unnamed: C58.1, U4.2 (AREG)
unnamed: C62.1, U4.24 (DREG)
unnamed: C60.1, U4.3 (VREF)

Notes on the sheet:
SAI
Place all 33R near source
configure GPIO_CFG[3:0] to 11d also configure this one as master
I2C
all these should be 50Z

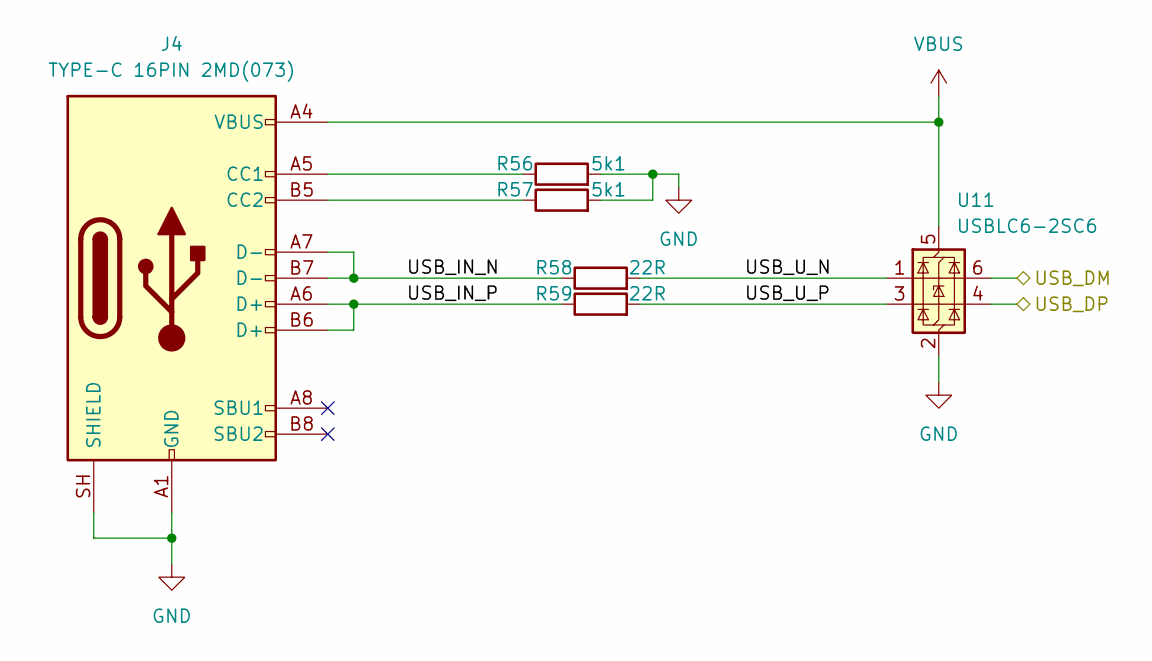
[picture p28: schematic usb.kicad_sch]

Parts:
J4: TYPE-C 16PIN 2MD(073); USB_C_Receptacle_HRO_TYPE-C-31-M-12
R56, R57: 5k1; R_0402_1005Metric
R58, R59: 22R; R_0402_1005Metric
U11: USBLC6-2SC6; SOT-23-6

Connections:
/MCU/USB_N: U11.6 (I/O1); also elsewhere on the board
/MCU/USB_P: U11.4 (I/O2); also elsewhere on the board
/USB/USB_IN_N: J4.A7 (D-), J4.B7 (D-), R58.1
/USB/USB_IN_P: J4.A6 (D+), J4.B6 (D+), R59.1
/USB/USB_U_N: R58.2, U11.1 (I/O1)
/USB/USB_U_P: R59.2, U11.3 (I/O2)
GND: J4.A1 (GND), J4.A12 (GND), J4.B1 (GND), J4.B12 (GND), J4.SH (SHIELD), R56.2, R57.2, U11.2 (GND); also elsewhere on the board
unnamed: J4.A5 (CC1), R56.1
unnamed: J4.B5 (CC2), R57.1
VBUS: J4.A4 (VBUS), J4.A9 (VBUS), J4.B4 (VBUS), J4.B9 (VBUS), U11.5 (VBUS); also elsewhere on the board

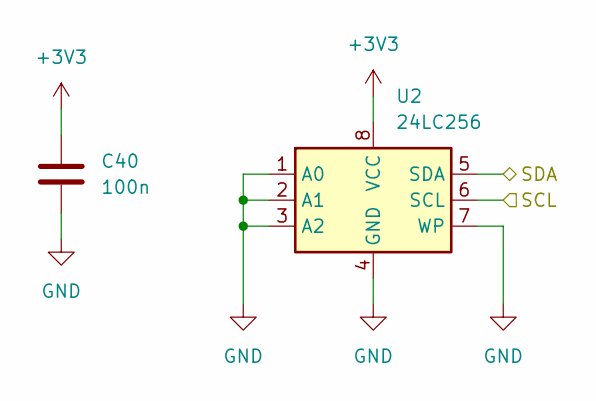
[picture p29: schematic EEPROM.kicad_sch]

Parts:
C40: 100n; C_0402_1005Metric
U2: 24LC256; SOIC-8_3.9x4.9mm_P1.27mm

Connections:
+3V3: C40.1, U2.8 (VCC); also elsewhere on the board
/MCU/I2C4_SCL: U2.6 (SCL); also elsewhere on the board
/MCU/I2C4_SDA: U2.5 (SDA); also elsewhere on the board
GND: C40.2, U2.1 (A0), U2.2 (A1), U2.3 (A2), U2.4 (GND), U2.7 (WP); also elsewhere on the board

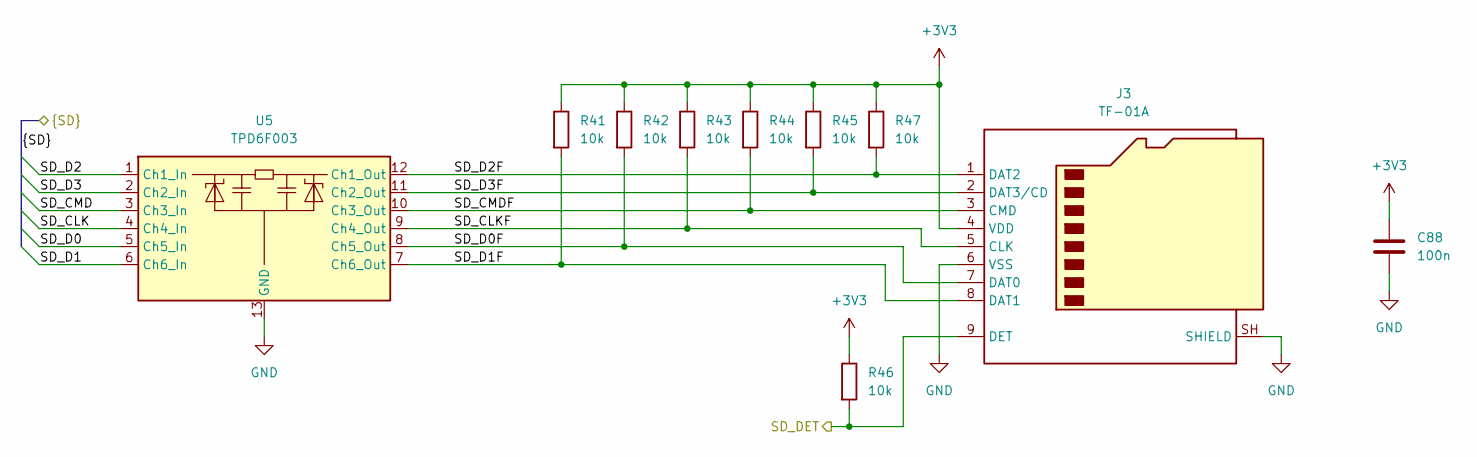
[picture p30: schematic SD.kicad_sch]

Parts:
C88: 100n; C_0402_1005Metric
J3: TF-01A
R41, R42, R43, R44, R45, R46, R47: 10k; R_0402_1005Metric
U5: TPD6F003; Texas_R-PWSON-N12_EP0.4x2mm

Connections:
+3V3: C88.1, J3.4 (VDD), R41.1, R42.1, R43.1, R44.1, R45.1, R46.1, R47.1; also elsewhere on the board
/MCU/SD_CLK: U5.4 (Ch4_In); also elsewhere on the board
/MCU/SD_CMD: U5.3 (Ch3_In); also elsewhere on the board
/MCU/SD_D0: U5.5 (Ch5_In); also elsewhere on the board
/MCU/SD_D1: U5.6 (Ch6_In); also elsewhere on the board
/MCU/SD_D2: U5.1 (Ch1_In); also elsewhere on the board
/MCU/SD_D3: U5.2 (Ch2_In); also elsewhere on the board
/MCU/SD_DET: J3.9 (DET), R46.2; also elsewhere on the board
/SD/SD_CLKF: J3.5 (CLK), R43.2, U5.9 (Ch4_Out)
/SD/SD_CMDF: J3.3 (CMD), R44.2, U5.10 (Ch3_Out)
/SD/SD_D0F: J3.7 (DAT0), R42.2, U5.8 (Ch5_Out)
/SD/SD_D1F: J3.8 (DAT1), R41.2, U5.7 (Ch6_Out)
/SD/SD_D2F: J3.1 (DAT2), R47.2, U5.12 (Ch1_Out)
/SD/SD_D3F: J3.2 (DAT3/CD), R45.2, U5.11 (Ch2_Out)
GND: C88.2, J3.6 (VSS), J3.SH (SHIELD), U5.13 (GND); also elsewhere on the board

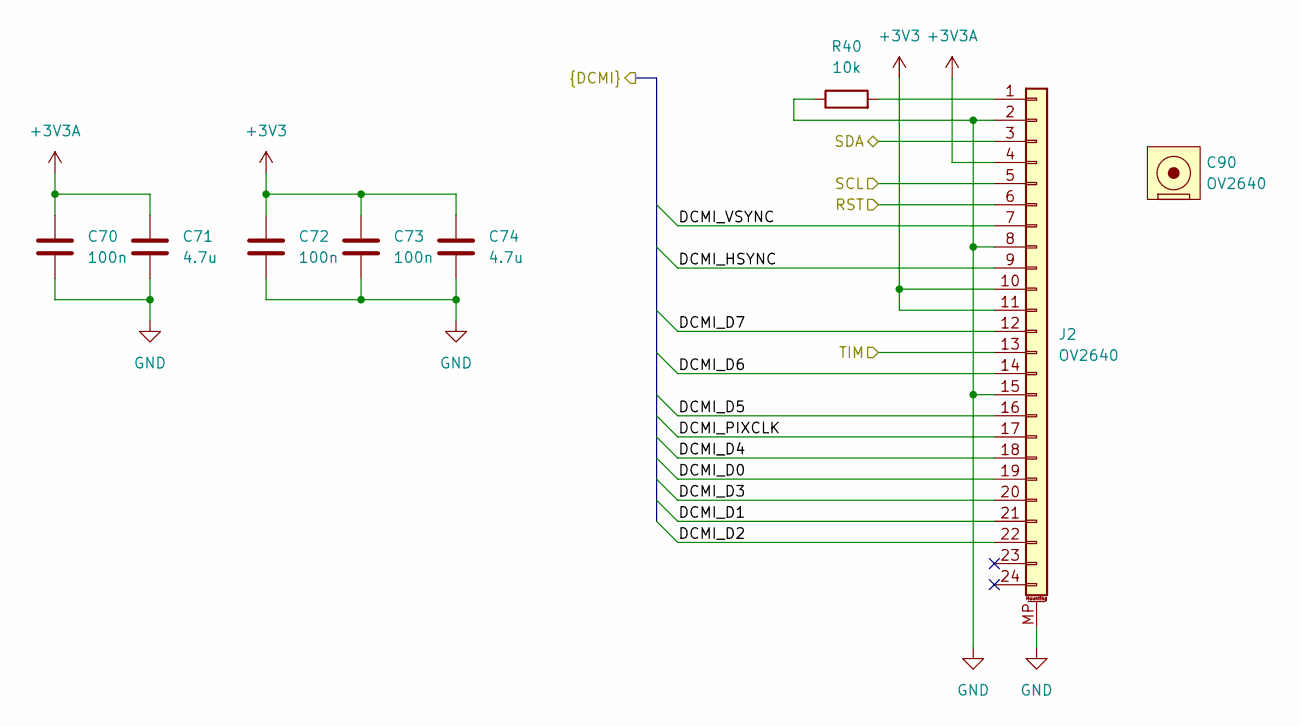
[picture p31: schematic camera.kicad_sch]

Parts:
C70, C72, C73: 100n; C_0402_1005Metric
C71, C74: 4.7u; C_0603_1608Metric
C90: OV2640
J2: OV2640; Hirose_FH12-24S-0.5SH_1x24-1MP_P0.50mm_Horizontal
R40: 10k; R_0402_1005Metric

Connections:
+3V3: C72.1, C73.1, C74.1, J2.10, J2.11; also elsewhere on the board
+3V3A: C70.1, C71.1, J2.4; also elsewhere on the board
/MCU/CAM_RST: J2.6; also elsewhere on the board
/MCU/CAM_TIM: J2.13; also elsewhere on the board
/MCU/DCMI_D0: J2.19; also elsewhere on the board
/MCU/DCMI_D1: J2.21; also elsewhere on the board
/MCU/DCMI_D2: J2.22; also elsewhere on the board
/MCU/DCMI_D3: J2.20; also elsewhere on the board
/MCU/DCMI_D4: J2.18; also elsewhere on the board
/MCU/DCMI_D5: J2.16; also elsewhere on the board
/MCU/DCMI_D6: J2.14; also elsewhere on the board
/MCU/DCMI_D7: J2.12; also elsewhere on the board
/MCU/DCMI_HSYNC: J2.9; also elsewhere on the board
/MCU/DCMI_PIXCLK: J2.17; also elsewhere on the board
/MCU/DCMI_VSYNC: J2.7; also elsewhere on the board
/MCU/I2C4_SCL: J2.5; also elsewhere on the board
/MCU/I2C4_SDA: J2.3; also elsewhere on the board
GND: C70.2, C71.2, C72.2, C73.2, C74.2, J2.2, J2.8, J2.15, J2.MP (MountPin), R40.1; also elsewhere on the board
unnamed: J2.1, R40.2

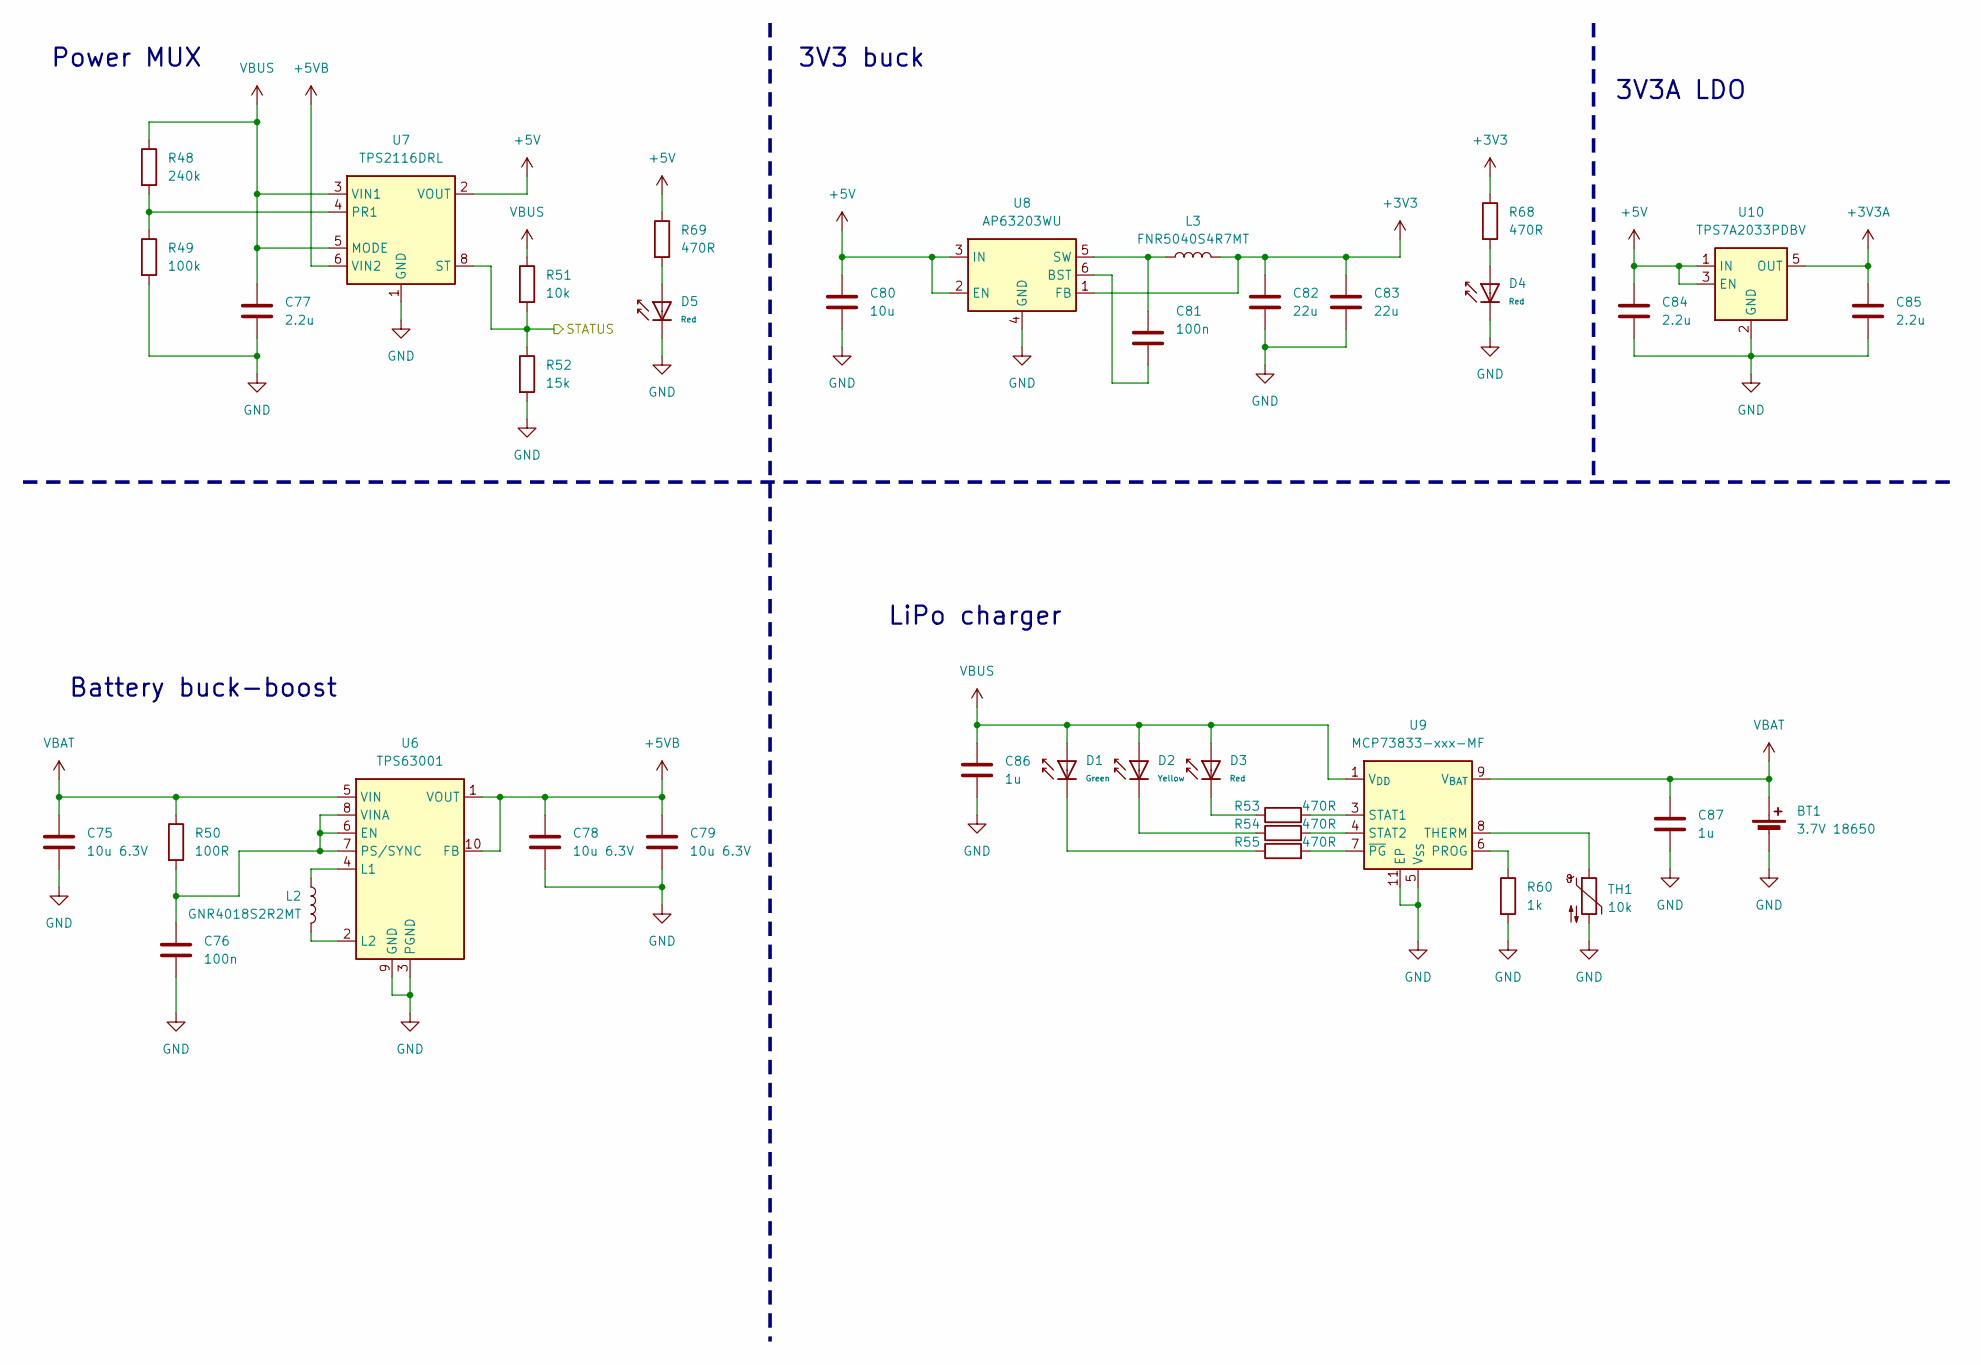
[picture p32: schematic power.kicad_sch]

Parts:
BT1: 3.7V 18650; SolderWire-1.5sqmm_1x02_P6mm_D1.7mm_OD3mm
C75, C78, C79: 10u 6.3V; C_0805_2012Metric
C76, C81: 100n; C_0402_1005Metric
C77: 2.2u; C_0402_1005Metric
C80: 10u; C_0603_1608Metric
C82, C83: 22u; C_0805_2012Metric
C84, C85: 2.2u; C_0603_1608Metric
C86, C87: 1u; C_0603_1608Metric
D1: Green; D_0603; Forward Voltage (VF) 1.6V~2.6V; Part NCD0603Y2; LCSC C89811
D2: Yellow; D_0603; Forward Voltage (VF) 1.6V~2.6V; Part NCD0603Y2; LCSC C89811
D3, D4, D5: Red; D_0603; Part KT-0603R; LCSC C2286
L2: GNR4018S2R2MT; L_Abracon_ASPI-4030S
L3: FNR5040S4R7MT; L_Changjiang_FNR5040S
R48: 240k; R_0402_1005Metric
R49: 100k; R_0402_1005Metric
R50: 100R; R_0402_1005Metric
R51: 10k; R_0402_1005Metric
R52: 15k; R_0402_1005Metric
R53, R54, R55, R68, R69: 470R; R_0402_1005Metric
R60: 1k; R_0402_1005Metric
TH1: 10k; JST_PH_B2B-PH-K_1x02_P2.00mm_Vertical
U6: TPS63001; Texas_DRC0010J_ThermalVias
U7: TPS2116DRL; SOT-583-8
U8: AP63203WU; TSOT-23-6
U9: MCP73833-xxx-MF; DFN-10-1EP_3x3mm_P0.5mm_EP1.58x2.35mm
U10: TPS7A2033PDBV; SOT-23-5

Connections:
+3V3: C82.1, C83.1, L3.2, R68.1, U8.1 (FB); also elsewhere on the board
+3V3A: C85.1, U10.5 (OUT); also elsewhere on the board
+5V: C80.1, C84.1, R69.1, U7.2 (VOUT), U7.7 (VOUT), U8.2 (EN), U8.3 (IN), U10.1 (IN), U10.3 (EN)
+5VB: C78.1, C79.1, U6.1 (VOUT), U6.10 (FB), U7.6 (VIN2)
/MCU/PWR_STATUS: R51.2, R52.1, U7.8 (ST); also elsewhere on the board
GND: BT1.2 (-), C75.2, C76.2, C77.2, C78.2, C79.2, C80.2, C82.2, C83.2, C84.2, C85.2, C86.2, C87.2, D4.1, D5.1, R49.2, R52.2, R60.2, TH1.2, U6.3 (PGND), U6.9 (GND), U6.11 (PGND), U7.1 (GND), U8.4 (GND), U9.5 (V_{SS}), U9.11 (EP), U10.2 (GND); also elsewhere on the board
unnamed: D1.1, R55.1
unnamed: D2.1, R54.1
unnamed: D3.1, R53.1
unnamed: D4.2, R68.2
unnamed: D5.2, R69.2
unnamed: C76.1, R50.2, U6.6 (EN), U6.7 (PS/SYNC), U6.8 (VINA)
unnamed: L2.2, U6.4 (L1)
unnamed: L2.1, U6.2 (L2)
unnamed: R48.2, R49.1, U7.4 (PR1)
unnamed: C81.2, U8.6 (BST)
unnamed: C81.1, L3.1, U8.5 (SW)
unnamed: R60.1, U9.6 (PROG)
unnamed: R53.2, U9.3 (STAT1)
unnamed: R54.2, U9.4 (STAT2)
unnamed: TH1.1, U9.8 (THERM)
unnamed: R55.2, U9.7 (~PG)
VBAT: BT1.1 (+), C75.1, C87.1, R50.1, U6.5 (VIN), U9.9 (V_{BAT}), U9.10 (V_{BAT})
VBUS: C77.1, C86.1, D1.2, D2.2, D3.2, R48.1, R51.1, U7.3 (VIN1), U7.5 (MODE), U9.1 (V_{DD}), U9.2 (V_{DD}); also elsewhere on the board

Notes on the sheet:
3V3 buck
3V3A LDO
LiPo charger
Battery buck-boost
Power MUX

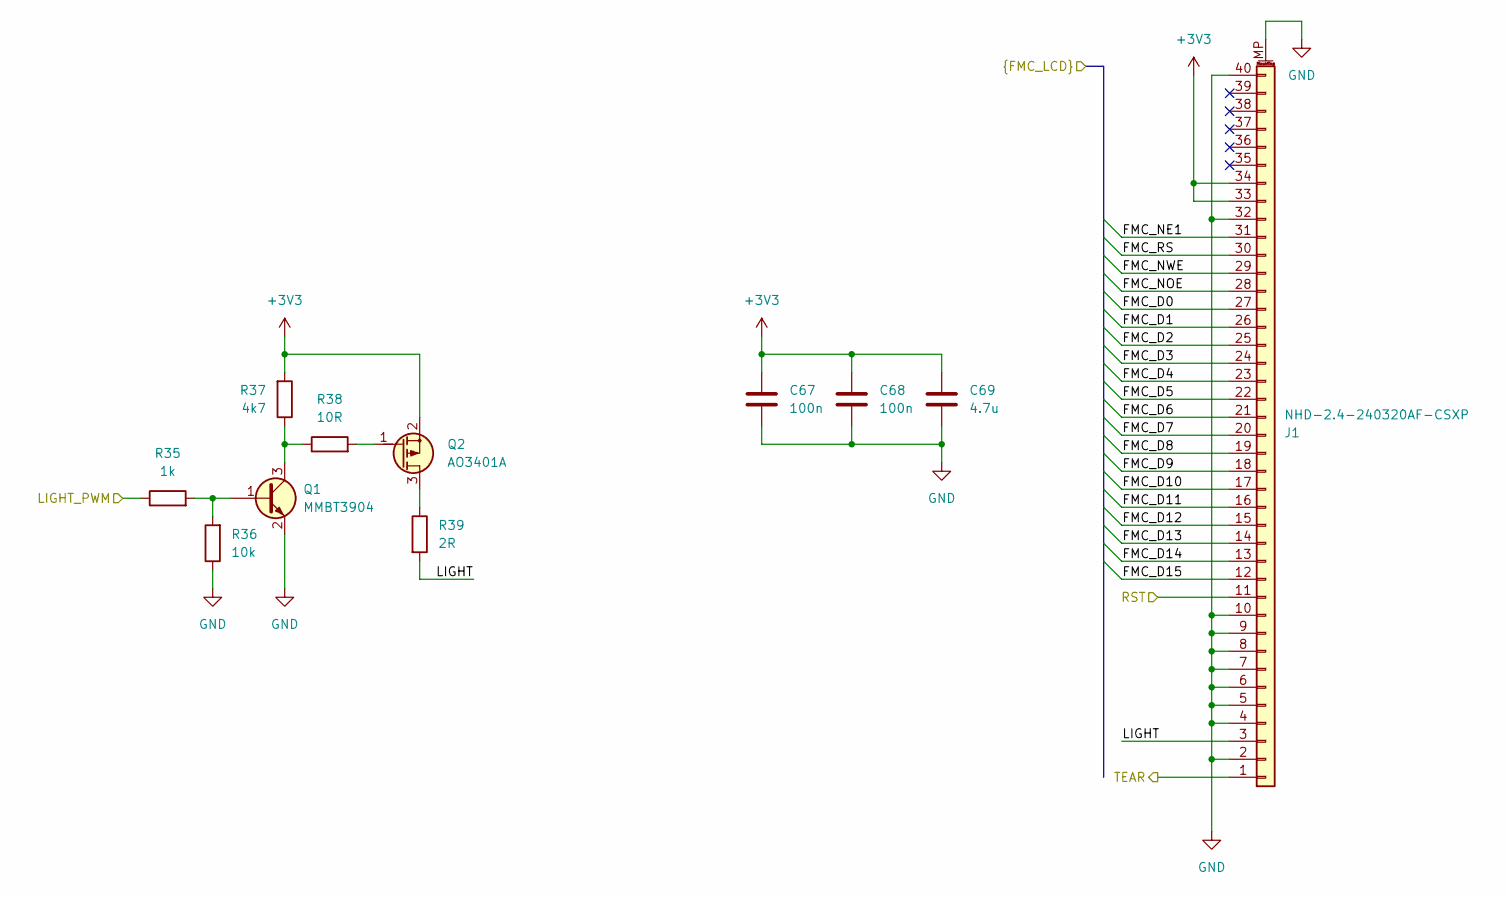
[picture p33: schematic display.kicad_sch]

Parts:
C67, C68: 100n; C_0402_1005Metric
C69: 4.7u; C_0603_1608Metric
J1: NHD-2.4-240320AF-CSXP; Hirose_FH12-40S-0.5SH_1x40-1MP_P0.50mm_Horizontal
Q1: MMBT3904; SOT-23
Q2: AO3401A; SOT-23
R35: 1k; R_0402_1005Metric
R36: 10k; R_0402_1005Metric
R37: 4k7; R_0402_1005Metric
R38: 10R; R_0402_1005Metric
R39: 2R; R_0603_1608Metric

Connections:
+3V3: C67.1, C68.1, C69.1, J1.33, J1.34, Q2.2 (S), R37.2; also elsewhere on the board
/Display/LIGHT: J1.3, R39.2
/MCU/FMC_D0: J1.27; also elsewhere on the board
/MCU/FMC_D1: J1.26; also elsewhere on the board
/MCU/FMC_D2: J1.25; also elsewhere on the board
/MCU/FMC_D3: J1.24; also elsewhere on the board
/MCU/FMC_D4: J1.23; also elsewhere on the board
/MCU/FMC_D5: J1.22; also elsewhere on the board
/MCU/FMC_D6: J1.21; also elsewhere on the board
/MCU/FMC_D7: J1.20; also elsewhere on the board
/MCU/FMC_D8: J1.19; also elsewhere on the board
/MCU/FMC_D9: J1.18; also elsewhere on the board
/MCU/FMC_D10: J1.17; also elsewhere on the board
/MCU/FMC_D11: J1.16; also elsewhere on the board
/MCU/FMC_D12: J1.15; also elsewhere on the board
/MCU/FMC_D13: J1.14; also elsewhere on the board
/MCU/FMC_D14: J1.13; also elsewhere on the board
/MCU/FMC_D15: J1.12; also elsewhere on the board
/MCU/FMC_NE1: J1.31; also elsewhere on the board
/MCU/FMC_NOE: J1.28; also elsewhere on the board
/MCU/FMC_NWE: J1.29; also elsewhere on the board
/MCU/FMC_RS: J1.30; also elsewhere on the board
/MCU/LCD_RST: J1.11; also elsewhere on the board
/MCU/LIGHT_PWM: R35.1; also elsewhere on the board
/MCU/TEAR: J1.1; also elsewhere on the board
GND: C67.2, C68.2, C69.2, J1.2, J1.4, J1.5, J1.6, J1.7, J1.8, J1.9, J1.10, J1.32, J1.40, J1.MP (MountPin), Q1.2 (E), R36.1; also elsewhere on the board
unnamed: Q1.1 (B), R35.2, R36.2
unnamed: Q1.3 (C), R37.1, R38.1
unnamed: Q2.3 (D), R39.1
unnamed: Q2.1 (G), R38.2
