Epicotch/Acoustic-Camera/Microphone board/Microphone board.kicad_pcb

## KiCad design Microphone board/Microphone board.kicad_pcb (continued)

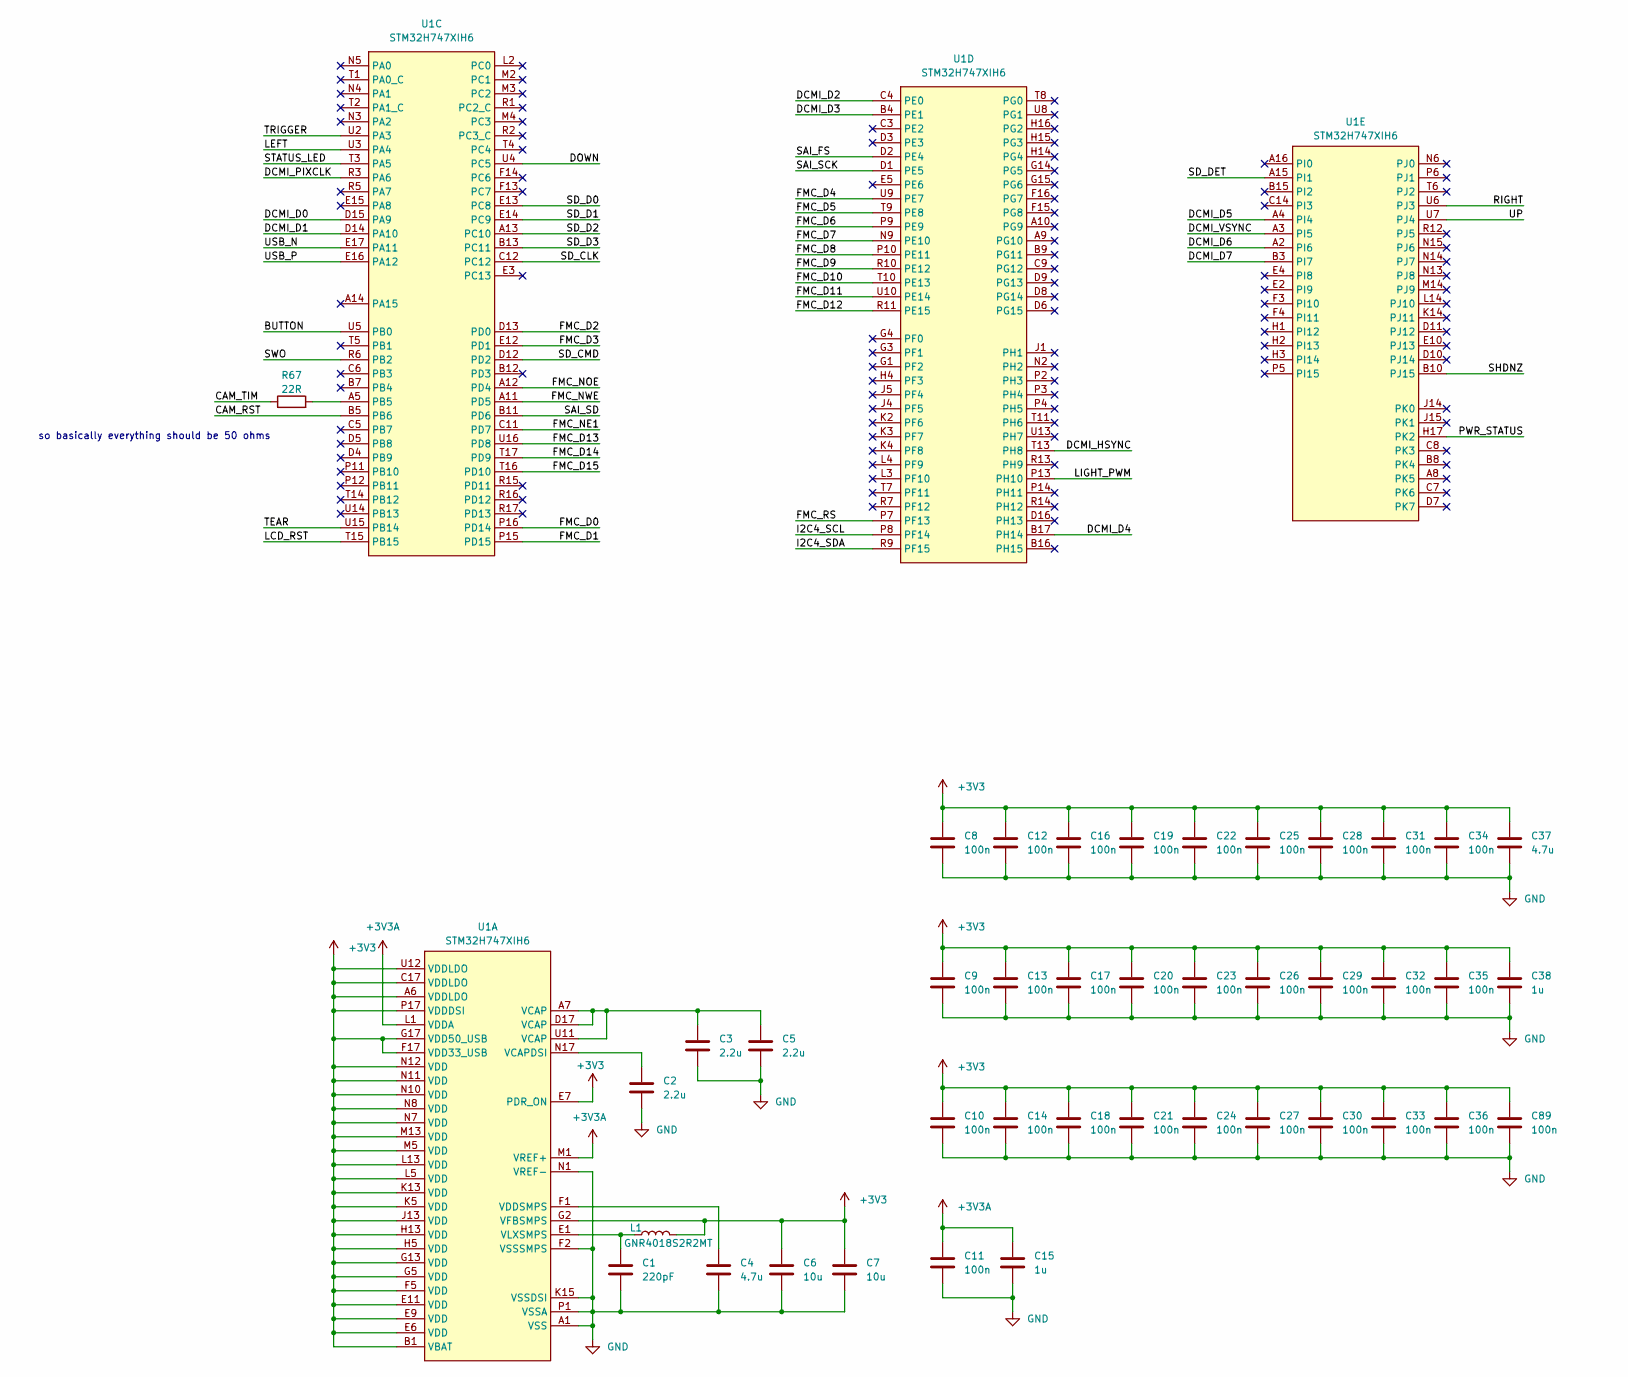
[picture p34: schematic MCU.kicad_sch, part in row 1, column 1]

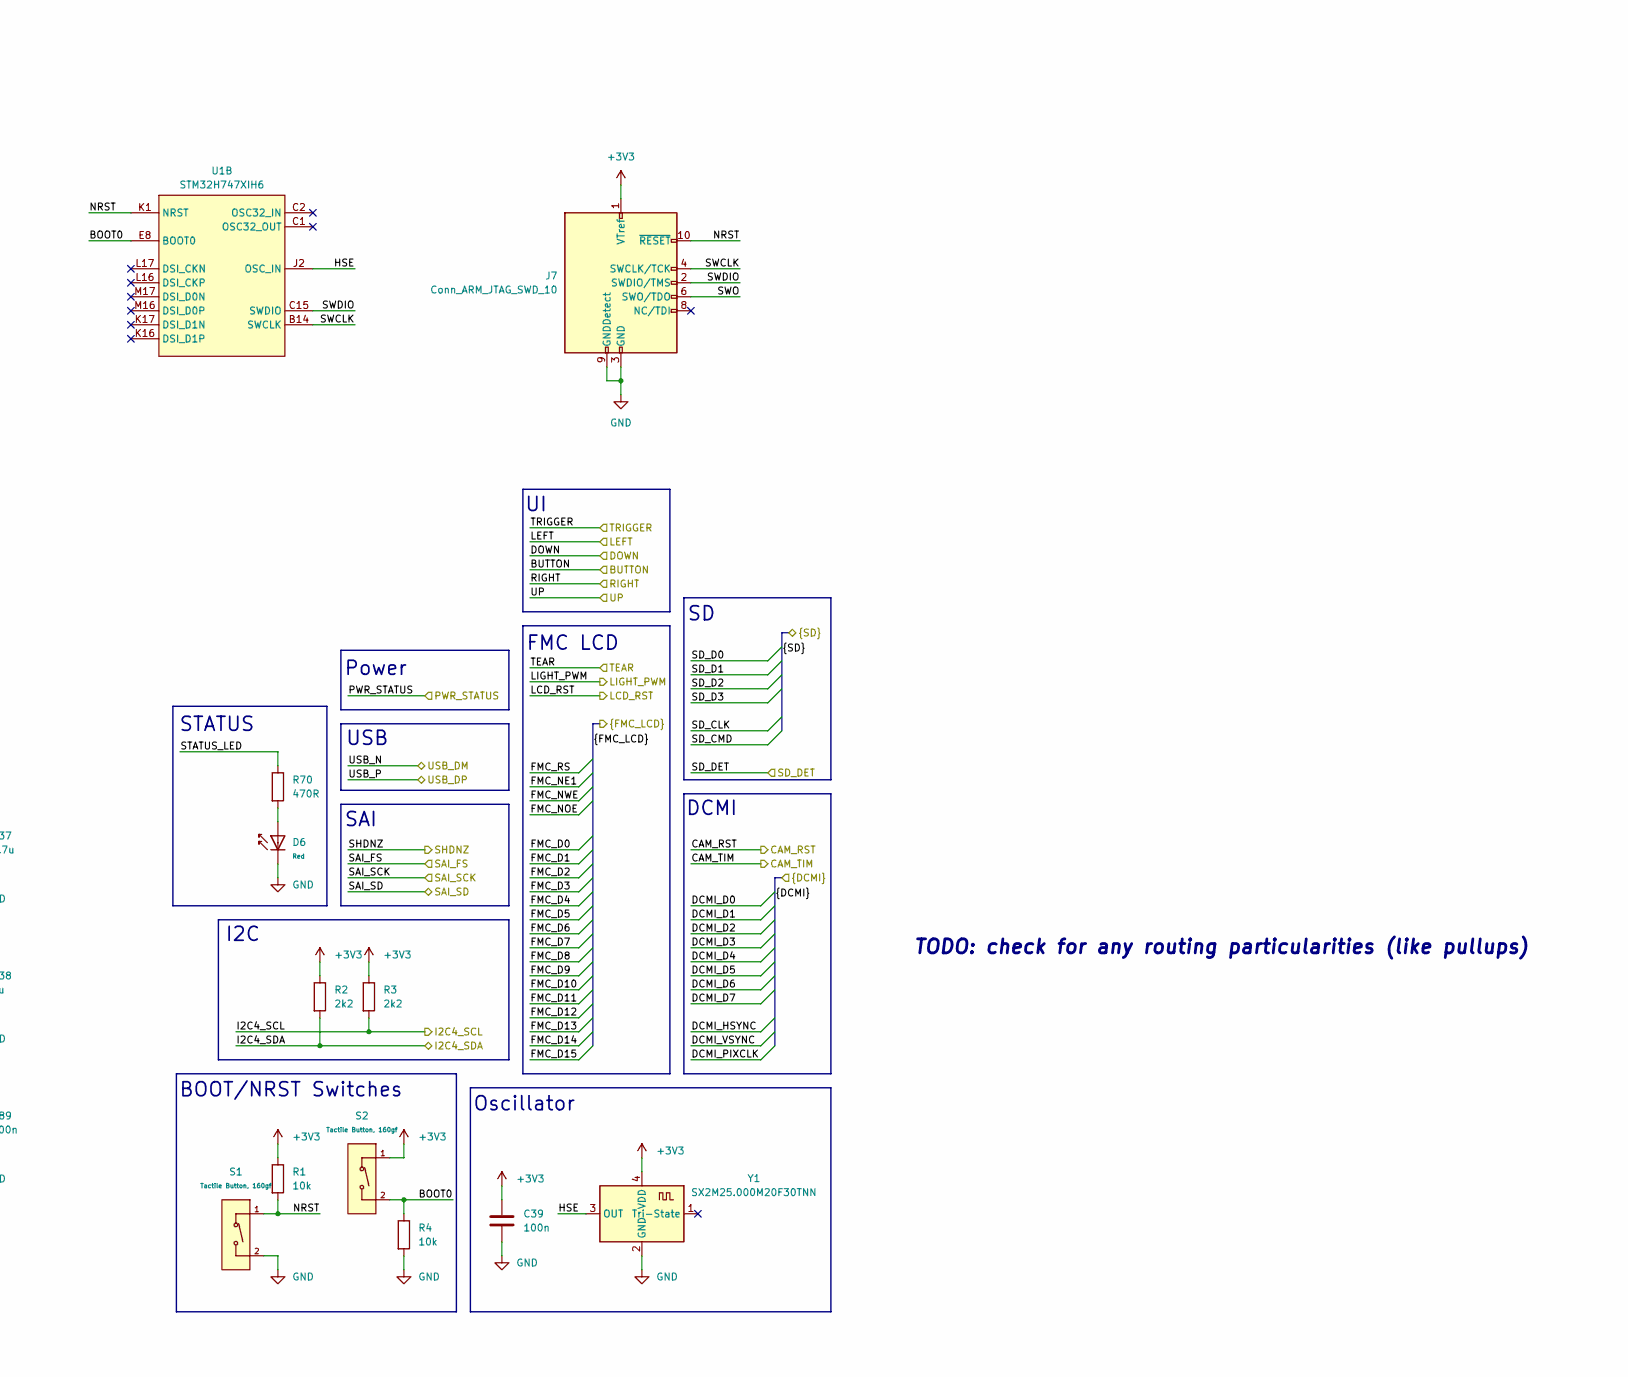
[picture p35: schematic MCU.kicad_sch, part in row 1, column 2]

Parts:
C1: 220pF; C_0402_1005Metric
C2, C3, C5: 2.2u; C_0603_1608Metric
C4, C37: 4.7u; C_0603_1608Metric
C6, C7: 10u; C_0805_2012Metric
C8, C9, C10, C11, C12, C13, C14, C16, C17, C18, C19, C20, C21, C22, C23, C24, C25, C26, C27, C28, C29, C30, C31, C32, C33, C34, C35, C36, C89: 100n; C_0201_0603Metric
C15, C38: 1u; C_0603_1608Metric
C39: 100n; C_0402_1005Metric
D6: Red; D_0603; Part KT-0603R; LCSC C2286
J7: Conn_ARM_JTAG_SWD_10; PinHeader_2x05_P1.27mm_Vertical_SMD
L1: GNR4018S2R2MT; L_Abracon_ASPI-4030S
R1, R4: 10k; R_0402_1005Metric
R2, R3: 2k2; R_0402_1005Metric
R67: 22R; R_0402_1005Metric
R70: 470R; R_0402_1005Metric
S1, S2: Tactile Button, 160gf; SW_TS-1088-AR02016; Voltage Rating (Dc) 12V; Part TS-1088-AR02016; LCSC C720477
U1: STM32H747XIH6; TFBGA-265_14x14mm_Layout17x17_P0.8mm
Y1: SX2M25.000M20F30TNN; Oscillator_SMD_Kyocera_KC2520Z-4Pin_2.5x2.0mm

Connections:
+3V3: C6.1, C7.1, C8.1, C9.1, C10.1, C12.1, C13.1, C14.1, C16.1, C17.1, C18.1, C19.1, C20.1, C21.1, C22.1, C23.1, C24.1, C25.1, C26.1, C27.1, C28.1, C29.1, C30.1, C31.1, C32.1, C33.1, C34.1, C35.1, C36.1, C37.1, C38.1, C39.1, C89.1, J7.1 (VTref), L1.2, R1.1, R2.1, R3.1, S2.1 (A), U1.A6 (VDDLDO), U1.B1 (VBAT), U1.C17 (VDDLDO), U1.E6 (VDD), U1.E7 (PDR_ON), U1.E9 (VDD), U1.E11 (VDD), U1.F5 (VDD), U1.F17 (VDD33_USB), U1.G2 (VFBSMPS), U1.G5 (VDD), U1.G13 (VDD), U1.G17 (VDD50_USB), U1.H5 (VDD), U1.H13 (VDD), U1.J13 (VDD), U1.K5 (VDD), U1.K13 (VDD), U1.L5 (VDD), U1.L13 (VDD), U1.M5 (VDD), U1.M13 (VDD), U1.N7 (VDD), U1.N8 (VDD), U1.N10 (VDD), U1.N11 (VDD), U1.N12 (VDD), U1.P17 (VDDDSI), U1.U12 (VDDLDO), Y1.4 (VDD); also elsewhere on the board
+3V3A: C11.1, C15.1, U1.L1 (VDDA), U1.M1 (VREF+); also elsewhere on the board
/MCU/BOOT0: R4.1, S2.2 (B), U1.E8 (BOOT0)
/MCU/BUTTON: U1.U5 (PB0); also elsewhere on the board
/MCU/CAM_RST: U1.B5 (PB6); also elsewhere on the board
/MCU/CAM_TIM: R67.1; also elsewhere on the board
/MCU/DCMI_D0: U1.D15 (PA9); also elsewhere on the board
/MCU/DCMI_D1: U1.D14 (PA10); also elsewhere on the board
/MCU/DCMI_D2: U1.C4 (PE0); also elsewhere on the board
/MCU/DCMI_D3: U1.B4 (PE1); also elsewhere on the board
/MCU/DCMI_D4: U1.B17 (PH14); also elsewhere on the board
/MCU/DCMI_D5: U1.A4 (PI4); also elsewhere on the board
/MCU/DCMI_D6: U1.A2 (PI6); also elsewhere on the board
/MCU/DCMI_D7: U1.B3 (PI7); also elsewhere on the board
/MCU/DCMI_HSYNC: U1.T13 (PH8); also elsewhere on the board
/MCU/DCMI_PIXCLK: U1.R3 (PA6); also elsewhere on the board
/MCU/DCMI_VSYNC: U1.A3 (PI5); also elsewhere on the board
/MCU/DOWN: U1.U4 (PC5); also elsewhere on the board
/MCU/FMC_D0: U1.P16 (PD14); also elsewhere on the board
/MCU/FMC_D1: U1.P15 (PD15); also elsewhere on the board
/MCU/FMC_D2: U1.D13 (PD0); also elsewhere on the board
/MCU/FMC_D3: U1.E12 (PD1); also elsewhere on the board
/MCU/FMC_D4: U1.U9 (PE7); also elsewhere on the board
/MCU/FMC_D5: U1.T9 (PE8); also elsewhere on the board
/MCU/FMC_D6: U1.P9 (PE9); also elsewhere on the board
/MCU/FMC_D7: U1.N9 (PE10); also elsewhere on the board
/MCU/FMC_D8: U1.P10 (PE11); also elsewhere on the board
/MCU/FMC_D9: U1.R10 (PE12); also elsewhere on the board
/MCU/FMC_D10: U1.T10 (PE13); also elsewhere on the board
/MCU/FMC_D11: U1.U10 (PE14); also elsewhere on the board
/MCU/FMC_D12: U1.R11 (PE15); also elsewhere on the board
/MCU/FMC_D13: U1.U16 (PD8); also elsewhere on the board
/MCU/FMC_D14: U1.T17 (PD9); also elsewhere on the board
/MCU/FMC_D15: U1.T16 (PD10); also elsewhere on the board
/MCU/FMC_NE1: U1.C11 (PD7); also elsewhere on the board
/MCU/FMC_NOE: U1.A12 (PD4); also elsewhere on the board
/MCU/FMC_NWE: U1.A11 (PD5); also elsewhere on the board
/MCU/FMC_RS: U1.P7 (PF13); also elsewhere on the board
/MCU/HSE: U1.J2 (OSC_IN), Y1.3 (OUT)
/MCU/I2C4_SCL: R3.2, U1.P8 (PF14); also elsewhere on the board
/MCU/I2C4_SDA: R2.2, U1.R9 (PF15); also elsewhere on the board
/MCU/LCD_RST: U1.T15 (PB15); also elsewhere on the board
/MCU/LEFT: U1.U3 (PA4); also elsewhere on the board
/MCU/LIGHT_PWM: U1.P13 (PH10); also elsewhere on the board
/MCU/NRST: J7.10 (~RESET), R1.2, S1.1 (A), U1.K1 (NRST)
/MCU/PWR_STATUS: U1.H17 (PK2); also elsewhere on the board
/MCU/RIGHT: U1.U6 (PJ3); also elsewhere on the board
/MCU/SAI_FS: U1.D2 (PE4); also elsewhere on the board
/MCU/SAI_SCK: U1.D1 (PE5); also elsewhere on the board
/MCU/SAI_SD: U1.B11 (PD6); also elsewhere on the board
/MCU/SD_CLK: U1.C12; also elsewhere on the board
/MCU/SD_CMD: U1.D12 (PD2); also elsewhere on the board
/MCU/SD_D0: U1.E13 (PC8); also elsewhere on the board
/MCU/SD_D1: U1.E14 (PC9); also elsewhere on the board
/MCU/SD_D2: U1.A13 (PC10); also elsewhere on the board
/MCU/SD_D3: U1.B13 (PC11); also elsewhere on the board
/MCU/SD_DET: U1.A15 (PI1); also elsewhere on the board
/MCU/SHDNZ: U1.B10 (PJ15); also elsewhere on the board
/MCU/STATUS_LED: R70.1, U1.T3 (PA5)
/MCU/SWCLK: J7.4 (SWCLK/TCK), U1.B14 (SWCLK)
/MCU/SWDIO: J7.2 (SWDIO/TMS), U1.C15 (SWDIO)
/MCU/SWO: J7.6 (SWO/TDO), U1.R6 (PB2)
/MCU/TEAR: U1.U15 (PB14); also elsewhere on the board
/MCU/TRIGGER: U1.U2 (PA3); also elsewhere on the board
/MCU/UP: U1.U7 (PJ4); also elsewhere on the board
/MCU/USB_N: U1.E17 (PA11); also elsewhere on the board
/MCU/USB_P: U1.E16 (PA12); also elsewhere on the board
GND: C1.2, C2.2, C3.2, C4.2, C5.2, C6.2, C7.2, C8.2, C9.2, C10.2, C11.2, C12.2, C13.2, C14.2, C15.2, C16.2, C17.2, C18.2, C19.2, C20.2, C21.2, C22.2, C23.2, C24.2, C25.2, C26.2, C27.2, C28.2, C29.2, C30.2, C31.2, C32.2, C33.2, C34.2, C35.2, C36.2, C37.2, C38.2, C39.2, C89.2, D6.1, J7.3 (GND), J7.5 (GND), J7.9 (GNDDetect), R4.2, S1.2 (B), U1.A1 (VSS), U1.A17 (VSS), U1.B2 (VSS), U1.B6 (VSS), U1.C10 (VSS), U1.C13 (VSS), U1.C16 (VSS), U1.F2 (VSSSMPS), U1.G7 (VSS), U1.G8 (VSS), U1.G9 (VSS), U1.G10 (VSS), U1.G11 (VSS), U1.G16 (VSS), U1.H7 (VSS), U1.H8 (VSS), U1.H9 (VSS), U1.H10 (VSS), U1.H11 (VSS), U1.J3 (VSS), U1.J7 (VSS), U1.J8 (VSS), U1.J9 (VSS), U1.J10 (VSS), U1.J11 (VSS), U1.J16 (VSS), U1.J17 (VSS), U1.K7 (VSS), U1.K8 (VSS), U1.K9 (VSS), U1.K10 (VSS), U1.K11 (VSS), U1.K15 (VSSDSI), U1.L7 (VSS), U1.L8 (VSS), U1.L9 (VSS), U1.L10 (VSS), U1.L11 (VSS), U1.N1 (VREF-), U1.N16 (VSS), U1.P1 (VSSA), U1.R4 (VSS), U1.R8 (VSS), U1.T12 (VSS), U1.U1 (VSS), U1.U17 (VSS), Y1.2 (GND); also elsewhere on the board
unnamed: C3.1, C5.1, U1.A7 (VCAP), U1.D17 (VCAP), U1.U11 (VCAP)
unnamed: D6.2, R70.2
unnamed: C2.1, U1.N17 (VCAPDSI)
unnamed: C4.1, U1.F1 (VDDSMPS)
unnamed: C1.1, L1.1, U1.E1 (VLXSMPS)
unnamed: R67.2, U1.A5 (PB5)

Notes on the sheet:
USB
Oscillator
FMC LCD
DCMI
STATUS
SAI
so basically everything should be 50 ohms
TODO: check for any routing particularities (like pullups)
BOOT/NRST Switches
I2C
Power

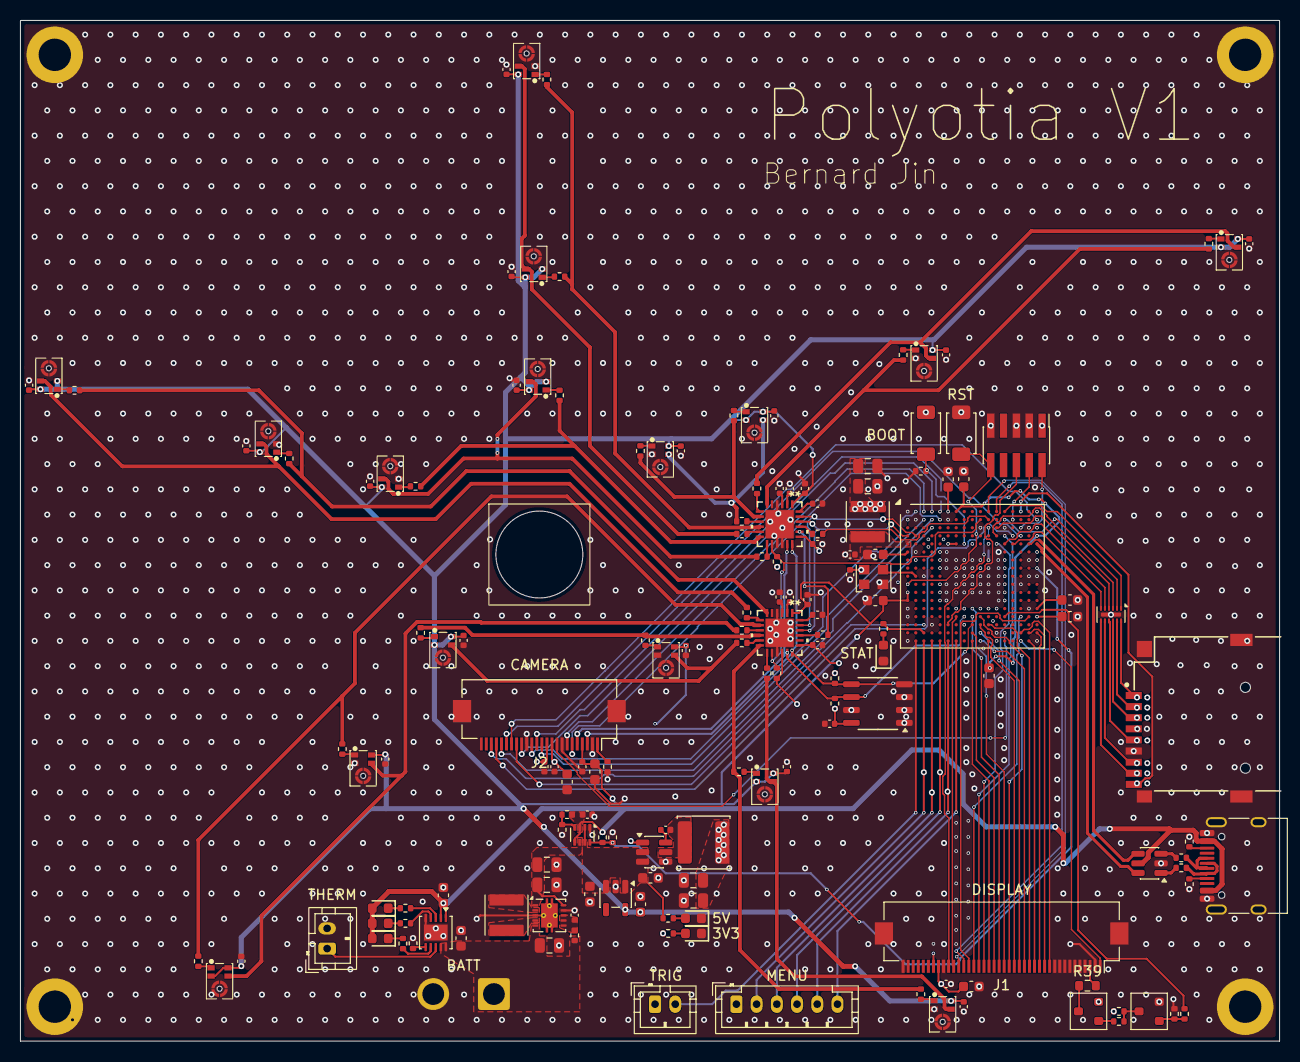
[picture p36: board Microphone board.kicad_pcb from above]

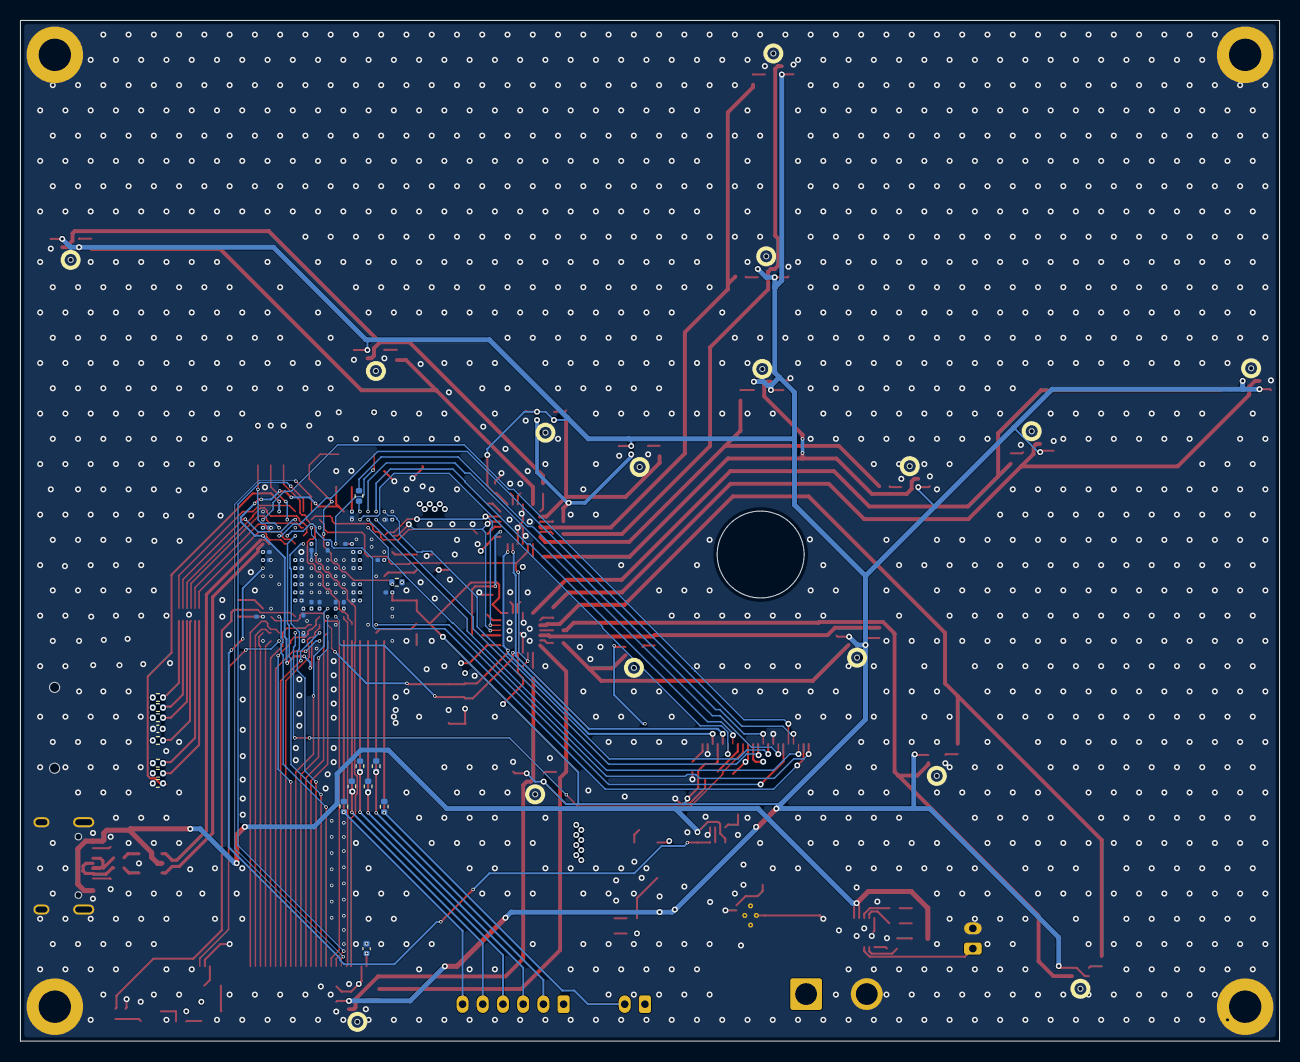
[picture p37: board Microphone board.kicad_pcb from below]

Board: 4 copper layers, 124.6 x 101.0 mm, 212 parts (46 on the bottom side), 161 nets.
