Epicotch/Acoustic-Camera/Firmware/Firmware.ioc

Mcu.UserName=STM32H747XIHx
PA0_C.Signal=ADCx_INP0
PA10.Signal=DCMI_D1
PA11.Signal=USB_OTG_FS_DM
PA12.Signal=USB_OTG_FS_DP
PA3.GPIO_Label=TRIGGER
PA3.Signal=GPIO_Input
PA4.GPIO_Label=LEFT
PA4.Signal=GPIO_Input
PA5.GPIO_Label=STATUS_LED
PA5.Signal=GPIO_Output
PA6.Signal=DCMI_PIXCLK
PA9.Signal=DCMI_D0
PB0.GPIO_Label=BUTTON
PB0.Signal=GPIO_Input
PB14.GPIO_Label=TEAR
PB14.Signal=GPXTI14
PB15.GPIO_Label=LCD_RST
PB15.Signal=GPIO_Output
PB5.Signal=S_TIM3_CH2
PB6.GPIO_Label=CAM_RST
PB6.Signal=GPIO_Output
PC10.Signal=SDMMC1_D2
PC11.Signal=SDMMC1_D3
PC12.Signal=SDMMC1_CK
PC5.GPIO_Label=DOWN
PC5.Signal=GPIO_Input
PC8.Signal=SDMMC1_D0
PC9.Signal=SDMMC1_D1
PD0.Signal=FMC_D2_DA2
PD1.Signal=FMC_D3_DA3
PD10.Signal=FMC_D15_DA15
PD14.Signal=FMC_D0_DA0
PD15.Signal=FMC_D1_DA1
PD2.Signal=SDMMC1_CMD
PD4.Signal=FMC_NOE
PD5.Signal=FMC_NWE
PD6.Signal=SAI1_SD_A
PD7.Signal=FMC_NE1
PD8.Signal=FMC_D13_DA13
PD9.Signal=FMC_D14_DA14
PE0.Signal=DCMI_D2
PE1.Signal=DCMI_D3
PE10.Signal=FMC_D7_DA7
PE11.Signal=FMC_D8_DA8
PE12.Signal=FMC_D9_DA9
PE13.Signal=FMC_D10_DA10
PE14.Signal=FMC_D11_DA11
PE15.Signal=FMC_D12_DA12
PE4.Signal=SAI1_FS_A
PE5.Signal=SAI1_SCK_A
PE7.Signal=FMC_D4_DA4
PE8.Signal=FMC_D5_DA5
PE9.Signal=FMC_D6_DA6
PF13.Signal=FMC_A7
PF14.Signal=I2C4_SCL
PF15.Signal=I2C4_SDA
PH10.GPIO_Label=BACKLIGHT
PH10.Signal=S_TIM5_CH1
PH14.Signal=DCMI_D4
PH8.Signal=DCMI_HSYNC
PI1.GPIO_Label=SDMMC_DET
PI1.Signal=GPIO_Input
PI4.Signal=DCMI_D5
PI5.Signal=DCMI_VSYNC
PI6.Signal=DCMI_D6
PI7.Signal=DCMI_D7
PJ15.GPIO_Label=SHDNZ
PJ15.Signal=GPIO_Output
PJ3.GPIO_Label=RIGHT
PJ3.Signal=GPIO_Input
PJ4.GPIO_Label=UP
PJ4.Signal=GPIO_Input
PK2.GPIO_Label=POWER_STATUS
PK2.Signal=GPIO_Input
