Epicotch/Acoustic-Camera/(commit log)

2026-06-04 baby steps
    [EEPROM.kicad_sch, MCU.kicad_sch, Microphone board.kicad_pcb, Microphone board.kicad_sch, camera.kicad_sch, display.kicad_sch, microphones.kicad_sch, trigger.kicad_sch]
2026-06-08 Made almost the rest of the schematic lol
    [EEPROM.kicad_sch, MCU.kicad_sch, Microphone board.kicad_pcb, Microphone board.kicad_sch, SD.kicad_sch, TF-01A--3DModel-STEP-56544.STEP, camera.kicad_sch, display.kicad_sch]
2026-06-08 almost finished power
    [EEPROM.kicad_sch, MCU.kicad_sch, Microphone board.kicad_pcb, Microphone board.kicad_sch, SD.kicad_sch, camera.kicad_sch, display.kicad_sch, microphones.kicad_sch]
2026-06-10 PCB routed
    [MCU.kicad_sch, Microphone board.kicad_pcb, Microphone board.kicad_sch, SD.kicad_sch, camera.kicad_sch, camera_OV2640_001.step, display.kicad_sch, microphones.kicad_sch]
2026-06-11 finished r1 of the board
    [MCU.kicad_sch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]
2026-06-13 widened traces
    [.step, Microphone board.kicad_pcb]
2026-06-27 Updated project firmware
    [MCU.kicad_sch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]
2026-07-10 Syncing stuff between computers
    [MCU.kicad_sch, Microphone board.kicad_pcb, dump.txt, microphones.kicad_sch]
2026-07-14 Working FFT!
    [dump.txt]
2026-07-18 Created python visualization
    [power.kicad_sch]
